NguyenDinhNhatNguyen/HRoT_SoC/README.md

# HRoT_SoC

SoC RISC-V hai lõi bất đối xứng với cách ly vật lý và khởi động bảo mật (Hardware Root of Trust & Secure Boot).
Master Core băm firmware của App Core bằng SHA-256 phần cứng (CPU hoặc Secure DMA), khối Boot_Verifier tự so digest với golden hash trong Boot ROM,
và App Core chỉ được nhả reset khi phần cứng báo VERIFIED. Ảnh sai thì Boot Guard khóa App tới khi cấp nguồn lại và xóa RAM App.

## Chạy nhanh (trong WSL, tại thư mục gốc repo)

| Lệnh | Việc |
| --- | --- |
| `make test` | Regression toàn bộ bằng QuestaSim + SystemC (TB đơn vị, lõi, UVM, HAL, ngoại vi APB, Boot_Verifier, SoC secure boot, firmware thật của hai lõi, ngắt, access fault, top ASIC `ASIC_Top`, VP) |
| `make cov` | Coverage trên QuestaSim (code coverage và covergroup của lõi, SHA-256, APB), báo cáo ở `build/cov/` |
| `make sim-unit` | 11 testbench đơn vị của lõi |
| `make sim-core TB=RISCV_Core_tb` | Mô phỏng lõi (mặc định `RISCV_Core_prog_tb`) |
| `make sim-uvm TEST=<test> SEED=<n>` | UVM AXI4-Lite (mặc định `axi4_lite_full_test`) |
| `make sim-soc` / `make sim-ip` / `make sim-bv` | Mô phỏng toàn SoC / ngoại vi APB (SYSCSR, UART, GPIO, TIMER, WDT, PLIC, Mailbox) / Boot_Verifier và cổng nhả App |
| `make vp` | Virtual Platform SystemC chạy HAL thật (image đúng và image bị sửa) |
| `make fw` | Build firmware Master và App (`fw/build/firmware_imem.hex`, `firmware_dmem.hex`, `app_firmware.hex`) |
| `make de2` | Quartus II 13.0sp1 cho DE2 (Cyclone II), kết quả trong `fpga/intel/de2/build` |
| `make xilinx PART=<part>` | Vivado 2025.2 cho Artix-7 thử, kết quả trong `fpga/xilinx/artix7/build` |
| `make kv260` | Vivado 2025.2 cho Kria KV260, ra `fpga/xilinx/kv260/build/kv260.bit` |
| `make asic-yosys` | Số sơ bộ ASIC của `SoC_Top` bằng Yosys + NanGate45 trong docker (xem `asic/README.md`) |
| `make asic-genus` | Tổng hợp `ASIC_Top` bằng Genus + GPDK45, chỉ chạy trên server trường (xem `asic/README.md`) |

Quy ước: chỉ làm việc trên nhánh `main`, chạy `make test` trước khi push. Mô phỏng chỉ dùng QuestaSim
(Makefile gọi Questa/Quartus/Vivado trên Windows qua WSL interop, đường dẫn đặt ở đầu Makefile).
Mỗi testbench in một dòng tổng kết bằng tiếng Anh (`... RESULT: PASS|FAIL`, `SUMMARY ...`, `TEST PASSED`) để `sim/regress.sh` đọc.

## Cấu trúc

```text
HRoT_SoC/
├── rtl/            RTL dùng chung cho mô phỏng và FPGA (xem rtl/README.md)
│   ├── core/       lõi RV32I 5 tầng, có Zicsr và trap máy
│   ├── bus/        AXI4-Lite master/slave, cầu AXI→APB, bộ giải mã APB, Secure DMA và tường lửa
│   ├── periph/     SYSCSR, Boot_Verifier, UART, GPIO, TIMER, WDT, PLIC-lite, Mailbox, FIFO
│   ├── mem/        Boot ROM, RAM, ROM App hai cổng
│   ├── crypto/     lõi SHA-256 và vỏ AXI
│   └── top/        RISCV_Core.v, SoC_Top.v
├── dv/             kiểm chứng (xem dv/README.md)
│   ├── tb/         testbench lõi, tb/soc/ chứa testbench ngoại vi APB và toàn SoC
│   ├── agents/ env/ tests/   môi trường UVM AXI4-Lite, SHA-256 và APB
│   └── sw/         mkhex.py: firmware thử viết tay cho SoC_Top_tb và FPGA
├── fw/             firmware: HAL, driver, crt0, linker script, Secure Boot (Master) và app demo (App)
├── vp/             Virtual Platform SystemC/TLM-2.0 (xem vp/README.md)
├── sim/            script Questa, regress.sh, run_vp.sh
├── fpga/           top bọc chân, constraints, script build và báo cáo FPGA (xem fpga/README.md)
├── asic/           top cấp chip ASIC_Top, SDC, luồng thử Yosys, luồng Genus (xem asic/README.md)
├── pd/             luồng ASIC (constraints, scripts, reports)
└── docs/           tài liệu (xem docs/README.md)
```

Tài liệu nên đọc trước: [docs/guides/Dev_Guide.md](docs/guides/Dev_Guide.md) (phân công, quy ước, cách chạy),
[docs/spec/SoC_Memory_Map.md](docs/spec/SoC_Memory_Map.md) (bản đồ địa chỉ và thanh ghi),
[docs/spec/Security_Model.md](docs/spec/Security_Model.md) (mô hình bảo mật, yêu cầu và truy vết) và
[docs/diagrams/](docs/diagrams/README.md) (bộ sơ đồ kiến trúc và lưu đồ, mở bằng draw.io).
