NguyenDinhNhatNguyen/HRoT_SoC/docs/project/Project_Status.md

# Trạng thái dự án — HRoT SoC

> Cập nhật: 13/11/2026. Ngày 12/11: Phát chạy Genus lần đầu cho `ASIC_Top` trên server trường (P-20), đạt timing từ 20 tới 8 ns, kết quả ở `asic/README.md`. Ngày 09/11: Phát thêm `asic/ASIC_Top.v` (bộ đồng bộ reset) và `asic/ASIC_Top.sdc` cho N-30. Ngày 07/11: lõi có `instr_stall` (I-09), `VERIFY_GATE` mặc định 1 trong `SoC_Top`, Nguyên chốt kit KV260 và bộ sơ đồ lên 21 trang (N-31). Ngày 05/11: Phát xong P-19 coverage, `make cov`. Ngày 04/11: Phát xong P-13 tới P-18 và P-24, Nguyên xong N-37 Boot_Verifier, N-38 mô hình bảo mật, N-39 đo lại FPGA. Phần RTL của Nguyên tới RTL freeze xong từ 26/10, N-37 bổ sung sau rà soát 04/11. Tiến độ chi tiết theo từng việc nằm ở [Google Sheet "HRoT_SoC — Tiến độ Đồ án 2"](https://docs.google.com/spreadsheets/d/13jJj9UP1Cxr8ZNFqzQnNTaiulD2_HaKOWAONfCnZnU4/edit) (tab Tổng hợp, Tiến độ, Mốc & Giao diện). Sheet là nguồn chính thức, khi lệch thì theo sheet. File này tóm tắt trạng thái kỹ thuật, sửa mỗi khi xong một mốc hoặc chốt một quyết định.

## 1. Tổng quan

- Toàn dự án 56/65 việc (86%, theo Sheet ngày 05/11, Sheet vẫn là nguồn chính thức): Nguyên 34/39, Phát 22/24, việc chung 0/2. Việc Nguyên còn lại: N-26 (RTL freeze), N-28, N-29, N-30, N-31. Việc Phát còn lại: P-20, P-21. Ngày 04/11: 55/65, Phát 21/24. Trước đó, 26/10: 45/61, Nguyên 31/36, Phát 14/23. Ngày 26/10 Phát làm xong P-09, P-10, P-11, P-23. Ngày 26/10 Nguyên làm xong N-19…N-25, N-27, N-32 và N-35. Ngày 25/10 thêm 6 việc phát sinh (N-32…N-36, P-22), danh sách rủi ro và hướng xử lý ở `Project_Plan.md` mục 8. RTL FREEZE: **22/11/2026** (mốc M2).
- SoC biên dịch và chạy được: Master boot từ Boot ROM riêng, băm cả 4 KB ROM App bằng CPU và bằng Secure DMA (qua tường lửa), so với golden hash đọc từ Boot ROM, rồi nhả App qua SYSCSR, hoặc khóa App bằng Boot Guard và xóa RAM App khi hash sai. Bus APB Secure có SYSCSR, UART0, GPIO0, TIMER0, WDT, PLIC-lite, Mailbox và Secure DMA. Thế giới App có bus APB riêng với UART1, GPIO1, TIMER1 và Mailbox. `SoC_Top_tb` chạy cả ảnh đúng lẫn ảnh bị sửa trên RTL (firmware thử `dv/sw/mkhex.py`). Dây ngắt của hai lõi đã nối vào cổng `irq_timer`/`irq_ext` của lõi (P-14, 27/10, I-01), `SoC_Irq_tb` kiểm ngắt timer, PLIC và Mailbox trên cả hai lõi.
- FPGA (26/10, đo với lõi đã đổi reset đồng bộ ở `IF_ID_Reg` và `ID_EX_Reg`, xem mục 4): DE2 9.358 LE (28%), 4.390 thanh ghi, 135 Kbit M4K, Fmax 53,02 MHz. Artix-7 xc7a35t 5.530 LUT (27%), 4.092 FF, WNS +3,519 ns @ 50 MHz. Đường găng DE2 nằm trong lõi (`Rd_WB` → forwarding ở ID → `RD2_EX`, slack +1,14 ns), không có đường nào của uncore trong top. Báo cáo ở `fpga/reports/`. Lần đo mới nhất (04/11, có P-09, P-14, P-24, Boot_Verifier và cổng nhả App bật): DE2 10.982 LE (33%), 4.925 thanh ghi, 135.168 bit, Fmax 54,07 MHz (slack +1,505 ns). Artix-7 6.136 LUT (29,5%), 4.401 FF, WNS +3,273 ns, WHS +0,014 ns (sát). Lần 27/10 (DE2): 10.509 LE, 54,21 MHz. Số của mọi lần đo: [FPGA_Results.md](FPGA_Results.md).
- Firmware Secure Boot thật có từ 27/10 (P-13): `fw/secure_boot/secure_boot.c` băm cả 4 KB ROM App bằng Secure DMA (`SWAP` + `PAD`, từ 29/10, P-15, trước đó bằng HAL), so golden ở `0xFE0` trong Boot ROM, nhả App hoặc khóa bằng Boot Guard, log qua UART0, kết quả ra LED GPIO0. Chạy trên VP (`vp_sim --fw`) và trên RTL (`SoC_Fw_tb`). Từ 29/10 có firmware App demo (`fw/app`, P-16): LED GPIO1 chạy theo TIMER1, gửi tin qua Mailbox, Master in tin đó ra UART0. `SoC_App_tb` chạy cả hai firmware thật với golden lấy từ build. `SoC_Top_tb` vẫn dùng firmware thử viết tay (`dv/sw/mkhex.py`).

Kết quả kiểm tra gần nhất trên Questa 10.2c (`make test`, 11/11 trên máy Phát): 22/22 PASS, 11 assertion của lõi 0 lỗi. Mục thứ 22 là `ASIC_Top_tb` (bộ đồng bộ reset của top ASIC), đưa vào `make test` cùng ngày. Lần 07/11 (`ce29a2e`) 21/21 và 05/11 cũng PASS toàn bộ. Hai mục UVM SHA-256 FAIL ngày 04/11 (341 lỗi) là do scoreboard tính sai chỉ số H0..H3 (`off[4:2] + 3'd4` được Questa tính ở 32 bit nên ra 8), DPI không lỗi, Phát sửa 05/11 (P-17). Cùng ngày chạy thêm trên Questa 19 lần test UVM mà sheet chỉ ghi kết quả Verilator, tất cả PASS. Bảng dưới là lần chạy 26/10, giữ để so:

| Nhóm | Kết quả |
| --- | --- |
| Lõi: 11 TB đơn vị, chương trình ISA, `RISCV_Core_tb`, hazard | PASS (11 TB đơn vị và UVM chạy được trên Questa sau khi Phát sửa P-22) |
| UVM AXI4-Lite (full, reset giữa giao dịch) và UVM SHA-256 (full, có reset) | PASS (26/10). 04/11: AXI4-Lite và APB PASS, SHA-256 hai mục FAIL. 05/11: tất cả PASS sau khi sửa scoreboard SHA |
| Boot_Verifier và cổng nhả App (`Boot_Verifier_tb`, 04/11) | PASS, 30/30: hash sai bit ở từ 0 và từ 7, SHA chưa xong hoặc bận, rollback, `MIN_VER` chỉ tăng, slot HMAC, `KEY_LOCK` qua SW reset, POR mở lại |
| SoC với `VERIFY_GATE = 1` (04/11) | PASS: ghi `APP_RUN` trước `CHECK` bị từ chối, ảnh đúng `STATUS` 0x9, ảnh sửa 0xA, đọc ngoài 4 KB ra `DECERR`, 7 lỗi bus cố ý được trap handler đếm đủ |
| HAL SHA-256 trên host | PASS |
| Ngoại vi APB (SYSCSR gồm BUS_ERR và Boot Guard, GPIO, UART, TIMER, WDT, PLIC-lite, Mailbox) | PASS, 79/79 check |
| SoC secure boot, ảnh đúng | PASS: hash của CPU và của DMA (SWAP bật và tắt) khớp golden trong Boot ROM, PLIC và tường lửa đúng, App chạy |
| SoC secure boot, ảnh bị sửa 1 bit (`+TAMPER`) | PASS: Boot Guard khóa App kể cả khi firmware cố nhả lại, RAM App về 0, không có yêu cầu DMA nào ra ngoài cửa sổ cho phép |
| VP (ảnh đúng và ảnh bị sửa) | PASS (UART log, WDT, Boot Guard, DMA, tường lửa) |
| `sha256_alias_test` (chạy riêng) | PASS |

Trên Verilator (Phát chạy, 23–25/10): UVM AXI4-Lite 15/15 PASS. UVM SHA-256 trên DUT thật: KAT, CTL (khoảng 960 check), RAND 40 message × 3 seed (khoảng 4.300–4.900 check), FULL, reset giữa message × 3, tất cả PASS, 0 lỗi.

Tới 29/10 (Phát chạy bằng iverilog, Verilator và trên host, **chưa chạy trên Questa**): 11 TB đơn vị, `RISCV_Core_tb`, hazard, chương trình `core_isa_test` và `core_trap_test` (có và không `bus_stall`), `SoC_Top_tb`, `SoC_Fw_tb` và `SoC_App_tb` (ảnh đúng và `+TAMPER`), `SoC_Irq_tb`, UVM 9 test (26/10), host `drv_host_test` 59/0, `sb_host_test` 69/0, `rom_image_test.py` 26/0, HAL 9.692/0, `make fw`, VP 4/4 đều PASS. `APB_Periph_tb` đạt 78/79 trên iverilog do race của PLIC ở thời điểm 0 (phần của Nguyên), trên Questa 26/10 thì 79/79.

## 2. Phần của Phát

| ID | Việc | Hạn | Trạng thái |
| --- | --- | --- | --- |
| P-01…P-06 | Lõi 5 tầng, hazard + test ISA, khung UVM, HAL + test plan, toolchain, load/store byte/half | ≤ 25/10 | ✅ Xong |
| P-07 | Sơ đồ khối datapath 5 tầng trong `docs/` | 13/09 | ✅ Vẽ từ Tuần 1, đưa vào repo 25/10: `docs/spec/Core_Datapath.md` + hình, có bảng đối chiếu RTL và 5 điểm nên sửa khi vẽ lại cho báo cáo (commit `fb0b577`) |
| P-08 | UVM sequence ngẫu nhiên cho SHA-256 (corner case) | 25/10 | ✅ Xong 25/10 (commit `bb59f25`). `sha256_alias_test` PASS sau khi Nguyên sửa RTL 25/10 |
| **P-09** | Zicsr + trap máy + cổng `irq_timer`/`irq_ext` | 01/11 | ✅ Xong 26/10 (commit `9f9e66a`): `Sys_Decoder`, `CSR_Unit`, `Pipe_Reg`, cổng `irq_timer`/`irq_ext` theo I-01 (xem `Dev_Guide.md` mục 2). Test `core_trap_test` (CSR, ECALL, EBREAK, lệnh không hợp lệ, MRET, ngắt timer/external) PASS có và không `bus_stall`, bắt được 9/9 lỗi cài thử. Dây ngắt nối trong `SoC_Top.v` từ 27/10 (P-14, R16). Access fault qua `data_err` (mcause 5/7) làm ở P-24 (04/11) |
| P-10 | Dọn `dv/tb` sang `dv/env`, `dv/agents` | 01/11 | ✅ Xong 26/10 (commit `9f9e66a`): `tb_top.sv`, `tb_sha256_top.sv` sang `dv/env/`, `axi4_lite_slave_model.sv` sang `dv/agents/`, sửa `sim/run_uvm.do`. `dv/tb/` chỉ còn TB trực tiếp |
| P-11 | Driver UART/GPIO theo `SoC_Memory_Map.md` | 01/11 | ✅ Xong 26/10 (commit `9f9e66a`): `fw/hal/uart.h`, `gpio.h` (một driver cho cả UART0/GPIO0 và UART1/GPIO1), thư viện `hal_drivers` trong CMake, test host `drv_host_test` 49/0 chạy trong `make -C fw/hal/test test` |
| P-12 | Cập nhật tài liệu này + `Dev_Guide.md`, thêm test của Phát vào `make test` | 01/11 | ✅ Xong (làm 24/10, vào `main` cùng commit P-08 `bb59f25`), sheet đã cập nhật 25/10 |
| P-23 | Sửa lỗi Quartus 10200 ở `IF_ID_Reg.v` và `ID_EX_Reg.v`: đổi `always @(posedge clk or posedge rst)` thành `always @(posedge clk)` (mục 4, R15) | 01/11 | ✅ Xong 26/10 (commit `9f9e66a`). Chạy lại iverilog: TB đơn vị, lõi, SoC (ảnh đúng và `+TAMPER`) PASS. `make de2` trên máy Phát 26/10 (bản có cả P-09): biên dịch sạch, không còn lỗi 10200, DE2 10.270 LE (31%), 4.840 thanh ghi, Fmax 53,73 MHz, đường găng vẫn trong lõi (`Rd_WB` → forwarding ở ID → `RD1_EX`, slack +1,39 ns) |
| P-22 | Sửa 2 lỗi script trên Questa 10.2c (mục 4) | 01/11 | ✅ Xong: Phát sửa 25/10 (commit `fb0b577`), Nguyên chạy `make test` trên Questa 26/10, 11 TB đơn vị và 4 test UVM PASS |
| P-13 | Firmware secure boot thật (HAL + UART + golden + LOCK), chạy VP rồi RTL | 08/11 | ✅ Xong 27/10 (`c739654`): `fw/secure_boot/secure_boot.c` theo đúng ghi chú (BUS_ERR → log, giữ App, xóa bit0. Golden băm đủ 4 KB ROM App). `linker.ld` đặt `.rodata` vào Boot ROM, golden ở `0xFE0` (I-03). Firmware build `-Os` (3,5/4 KB ROM). Test: `sb_host_test` 30/0 (8 nhánh, gồm lỗi bus, SHA hỏng, LOCK không xong), VP `--fw` ảnh đúng và bị sửa PASS, `SoC_Fw_tb` ảnh đúng và `+TAMPER` PASS. 04/11 theo ghi chú của Nguyên: mọi lỗi (self-test, bus, DMA) đều khóa App bằng Boot Guard như khi sai hash, WDT 1 s bật từ đầu và được đá mãi sau boot, kiểm `BUS_ERR` lại sau khi đọc golden. `sb_host_test` 80/0 |
| P-14 | Test assembly ngắt timer/external | 08/11 | ✅ Xong 27/10 (`c739654`): nối 4 dây ngắt trong `SoC_Top.v` (Phát làm, đã báo Nguyên). `SoC_Irq_tb` + `soc_irq_master.S`, `soc_irq_app.S`: TIMER0, GPIO0 qua PLIC, MEI trước MTI, Mailbox hai chiều, TIMER1. Master 5 ngắt, App 2 ngắt, PASS. Tháo từng dây hoặc đảo ưu tiên đều làm test FAIL |
| P-15 | FW dùng Secure DMA | 15/11 | ✅ Xong 29/10: driver `fw/hal/dma.c` (`dma_sha256`: kiểm DMA và SHA rảnh, chạy với `PAD`, polling có giới hạn và nghỉ giữa các lần đọc, xóa `DONE`, báo lỗi tường lửa, lỗi bus, timeout). Secure Boot băm ROM App bằng DMA `SWAP = 1`, khớp golden ở `0xFE0`. CPU không còn đọc ROM App, firmware còn 3.320/4.064 byte. Test: `sb_host_test` 63/0 (thêm tường lửa, DMA không xong, DMA hoặc SHA đang bận, bắt 10/10 lỗi cài thử), VP `--fw` PASS, `SoC_Fw_tb` ảnh đúng và `+TAMPER` PASS (DMA chạy 1 lần, 17.026 chu kỳ, CPU tự băm mất 34.143) |
| P-16 | FW App + `app_firmware.hex` + sinh golden hash | 15/11 | ✅ Xong 29/10: `fw/app` (UART1 "App running", LED GPIO1 chạy theo TIMER1, gửi `APP1` rồi số bước qua Mailbox), Master in tin Mailbox ra UART0 sau khi nhả App. `app.ld` chặn `.rodata`/`.data` vì lõi App không đọc được ROM của nó. `make fw` tạo `app_firmware.hex`/`.bin` đủ 4 KB và ghi golden vào `firmware_imem.hex` (`fw/tools/rom_image.py`, I-04). Driver Mailbox mới, `uart_put_hex32` bỏ bảng hằng. Test: `drv_host_test` 59/0, `sb_host_test` 69/0, `rom_image_test.py` 26/0, `SoC_App_tb` ảnh đúng và `+TAMPER` PASS, bắt 4/4 lỗi cài thử |
| P-17 | UVM agent APB + scoreboard SHA (DPI) | 15/11 | ✅ Xong 30/10 (`ae92653`): agent APB (`dv/agents/apb_*`, SVA giao thức) và top `tb_apb_top.sv` lái `APB_Decoder`, GPIO, TIMER, Mailbox hai phía thật cùng một slave RAM có wait state. `apb_scoreboard` dự đoán mọi lần đọc và `PSLVERR` của cả hai bus. Scoreboard SHA thụ động với golden `sha256_ref.c` qua DPI và reg model khớp chu kỳ, bật trong mọi test `sha256_*`. Verilator: `apb_full_test` 5 seed và `apb_reg_test` 2.000 transfer có reset PASS, 0 lỗi. `sha256_full_test` 1.701 lần đọc, 0 lỗi. Lỗi cài vào RTL mà sequence không thấy: scoreboard bắt 3/3 (DONE trễ 1 chu kỳ, HASH đọc 0 khi BUSY, TIMER ghi lệch). Lỗi cài vào Mailbox chưa build được trên Verilator. Questa 10.2c báo 3 lỗi làm cả 5 test UVM FAIL (Nguyên, 04/11): tên `check` trùng với `uvm_component`, gcc của Questa mặc định C89, kiểu virtual interface không có instance. Đã sửa 04/11 (`check_item`, `-ccflags -std=gnu99`, instance không dùng trong các top UVM). 05/11 sửa chỉ số H0..H3 của scoreboard SHA (Questa tính `off[4:2] + 3'd4` ở 32 bit). Questa 10.2c 05/11: 12 test UVM, 24 lần chạy nhiều seed, PASS 0 lỗi |
| P-18 | Test firmware toàn SoC + regression UVM | 22/11 | ✅ Xong 04/11 (commit `a05aef7`): firmware dùng Boot_Verifier theo I-08 (driver `fw/hal/boot_verifier.c`, đọc APP_VER ở `0x6000_0FFC`, CHECK MODE 0, VERIFIED và phần mềm cũng khớp thì KEY_LOCK rồi nhả App, đọc lại APP_RUN, lỗi thì khóa App với mã LED `BF`). `SoC_Fw_tb` và `SoC_App_tb` bật `VERIFY_GATE = 1`. VP có mô hình Boot_Verifier. `regress.sh`: SKIP tính là FAIL (`ALLOW_SKIP=1` để bỏ qua), TB 0 check không còn PASS, `SEED=<n>` đổi seed. Firmware build với `-flto` (3.384/4.032 byte). Test: `sb_host_test` 99/0, bắt 4/4 lỗi cài thử, VP 4/4, các TB SoC PASS. Questa 10.2c 05/11: `SoC_Fw_tb`, `SoC_App_tb` (ảnh đúng, `+TAMPER`), `SoC_Irq_tb` PASS |
| P-24 | Access fault qua `data_err` (cổng trong lõi + trap handler firmware) | 22/11 | ✅ Xong 04/11 (commit `dca8cbf`): `CSR_Unit` trap `mcause` 5/7 với `mtval` = địa chỉ khi `data_err` lúc truy cập kết thúc. `crt0.S` đặt `mtvec`, `trap_handler` của Master khóa App và KEY, LED `0xAF`. Nguyên nối `master_data_err` trong `SoC_Top` và thêm trap handler cho `mkhex.py` cùng ngày (`e14eb4f`), lõi App vẫn nối 0. Test: `core_trap_test` thêm load/store lỗi (có và không `bus_stall`), bắt 4/4 lỗi cài vào RTL, `sb_host_test` 102/0, `SoC_Fw_tb +FAULT` (ép `data_err` khi đọc APP_VER). Questa 10.2c 05/11: `core_trap_test` và `SoC_Fw_tb +FAULT` PASS |
| P-19 | Covergroup + thu coverage | 29/11 | ✅ Xong 05/11 (commit `4b3c481`): `make cov` (`sim/cov.sh`) chạy trên Questa 12 lần (lõi, SHA-256, APB) với code coverage và covergroup (`sha256_coverage.svh`, `apb_coverage.svh`, covergroup trong `RISCV_Core_prog_tb`, chỉ biên dịch khi có `+define+HROT_COV`). Functional coverage 16 covergroup đều 100%. Code coverage: `SHA256_Wrapper`, `SHA256_Core`, GPIO, TIMER, Mailbox 100%, lõi 99% statement, 98,6% branch. Coverage tìm ra 4 lỗ hổng test (ORI, FENCE/FENCE.I/WFI, mã lệnh dành riêng, CSR ID và ghi `mcause`/`mtval`), đã thêm vào `core_isa_test` và `core_trap_test`. Thêm `sha256_reg_test` (F-REG-01/02), `+RESET_EVERY_NS`, `pick_len` tôn trọng `+MAX_LEN`. 07/11: 11 assertion SVA bind vào lõi (`dv/tb/RISCV_Core_sva.sv`), bắt 3/3 lỗi cài vào `CSR_Unit`, trong đó 1 lỗi test chương trình không bắt được. Chi tiết: test plan SHA-256 mục 6 |
| P-20, P-21 | Báo cáo coverage + Genus · Innovus + so sánh PPA | 06/12 → 13/12 | P-20 đang làm: Genus chạy 12/11 (20 ns: slack +6,98 ns, 73.256 µm² logic, bộ nhớ là black box). P-21 chưa làm |

## 3. Giao diện Nguyên ↔ Phát

| ID | Nội dung | Hạn | Trạng thái |
| --- | --- | --- | --- |
| I-01 | Cổng ngắt của lõi: `irq_timer`, `irq_ext`: đầu vào mức cao, đồng bộ `clk`, giữ mức tới khi nguồn tự xóa (TIMER0: ghi `mtimecmp`, PLIC: claim/complete), lõi không bắt cạnh → `mip.MTIP` (bit 7) / `mip.MEIP` (bit 11), ưu tiên MEI > MTI. `data_err` mức cao cùng chu kỳ với `resp_valid` (nối `err_valid` của `AXI4_Lite_Master`) → access fault `mcause` 5 (load) / 7 (store), `mtval` = địa chỉ | 01/11 | ✅ **Đã chốt 25/10** (Phát). Lõi có cổng từ P-09 (26/10, commit `9f9e66a`), nối trong `SoC_Top` từ 27/10 (P-14). `data_err` có trong lõi từ 04/11 (P-24), nối vào lõi Master trong `SoC_Top` cùng ngày (`e14eb4f`), lõi App nối 0 |
| I-02 | Header địa chỉ firmware theo `SoC_Memory_Map.md`, đổi map phải báo trước | 01/11 | Nguyên |
| I-03 | Địa chỉ golden hash trong Boot ROM (cổng đọc dữ liệu) + đổi `linker.ld` đặt `.rodata` vào đó | 08/11 | ✅ Xong 27/10: `.rodata` trong Boot ROM, golden ở `0xFE0` (`SB_GOLDEN_ADDR`). Chốt 04/11: golden là 8 word big-endian H0..H7 (khớp Boot_Verifier), tag HMAC ở `0xFC0`, code dùng tới `0xFBF` |
| I-04 | Target CMake `app_firmware.hex` + bước sinh golden hash (băm **cả 4 KB** ROM App) | 15/11 | Phát. Xong 29/10 (P-16) |
| I-05 | SHA-256: 66 chu kỳ START→DONE, offset trống OKAY/0, ngoài slave DECERR | — | ✅ Đã chốt, RTL đã khớp từ 25/10 |
| I-06 | UART `BAUD_DIV` mặc định 26 = 115200 baud @ 50 MHz | — | ✅ Đã chốt |
| I-07 | Chỉ commit trên `main`, chạy trong WSL, mô phỏng Questa, `make test` PASS trước khi push | — | ✅ Đã chốt |
| I-08 | Firmware dùng Boot_Verifier (`0x4000_8000`), MODE 0: DMA băm xong thì không đụng SHA tới khi `CHECK` xong, ghi `APP_VER`, `CHECK`, chờ `CHECKED` có giới hạn. `VERIFIED` và phần mềm cũng khớp thì `KEY_LOCK` rồi `APP_CTRL = 1`, `FAIL` thì Boot Guard LOCK | 15/11 | ✅ Xong 04/11 (P-18), `VERIFY_GATE = 1` ở FPGA và TB firmware, mặc định 1 trong `SoC_Top` từ 07/11 |
| I-09 | Bộ nhớ cho ASIC (R8): SRAM macro đọc cạnh lên trễ 1 chu kỳ. MEM dùng lại `bus_stall`, IF có cổng `instr_stall` (đầu vào mức cao, đồng bộ `clk`). FPGA nối `instr_stall = 0` | 22/11 | ✅ Chốt 07/11, phía lõi xong 07/11 (`1cf00e6`). Còn Nguyên nối dây và làm bộ nhớ cạnh lên cho bản ASIC |

Các lỗi SoC/uncore liệt kê ở bản trước (SoC không compile, Master fetch ROM App, ROM đọc đồng bộ, `bus_stall` trễ, thiếu WSTRB, SHA chưa băm, Reset Controller treo, VP thiếu `sc_main`…) **đều đã được Nguyên sửa** trong các commit `459f4fe`…`bb8288a`.

## 4. Điểm cần lưu ý

- **Cổng nhả App bằng phần cứng (N-37, 04/11):** `Boot_Verifier` (APB slot 8, `0x4000_8000`) tự đọc golden hash từ Boot ROM và so 8 từ với digest SHA-256, cộng chống rollback (`MIN_VER`) và khóa HMAC (`KEY_LOCK`). Với `SoC_Top` `VERIFY_GATE = 1`, `SYSCSR` bỏ qua `APP_RUN` tới khi `VERIFIED`. `DE2_Top`, `Xilinx_Top` và các TB firmware bật cổng, `SoC_Irq_tb` để 0. Chi tiết: `docs/spec/SoC_Memory_Map.md` mục Boot_Verifier và `docs/spec/Security_Model.md`. Kèm theo: Boot_Verifier mượn cổng B của Boot ROM (cổng đọc thứ ba làm Quartus bỏ cả lõi Master, mô phỏng không thấy), ba bộ nhớ 4 KB giải mã đúng 4 KB (ngoài vùng ra `DECERR`), `master_data_err` nối vào lõi Master (P-24).
- **Việc của Nguyên:** N-33 (VP băm cả 4 KB ROM App), N-34 (`fw/hal/soc_map.h`), N-36 (`SYSCSR.BUS_ERR`) xong 25/10. Ngày 26/10 xong N-19 (PLIC-lite), N-20 (Boot Guard + Zeroization), N-21 (cổng đọc dữ liệu Boot ROM ở `0x0000_0000`), N-22 (Secure DMA + một master AXI dùng chung cho CPU và DMA), N-23 (tường lửa DMA), N-24 (bus APB thế giới App với UART1, GPIO1, TIMER1), N-25 (Mailbox), N-27 và N-32 (VP có Boot ROM, UART0, TIMER0, WDT, Boot Guard, DMA), N-35 (`SoC_Top_tb` băm image App, thêm ảnh bị sửa). N-26 (đóng băng RTL 22/11): phần của Phát (P-09, P-23) xong 26/10, dây ngắt nối trong `SoC_Top` 27/10 (P-14). N-18 xong: 52/52 chân trong `fpga/intel/de2/de2_pins.tcl` khớp bảng chân của DE2 User Manual v1.3.
- **Lỗi Quartus 13 trong lõi (Nguyên phát hiện 26/10, Phát sửa cùng ngày ở commit `9f9e66a`, P-23):** commit `fb0b577` gộp `if (rst || flush)` vào khối `always @(posedge clk or posedge rst)` của `IF_ID_Reg.v` và `ID_EX_Reg.v`. Quartus báo lỗi 10200 ("cannot match operand(s) in the condition to the corresponding edges") nên `make de2` không chạy được. Đề xuất đổi hai khối đó sang `always @(posedge clk)`, reset đồng bộ, hợp với `sys_rst` đồng bộ của SoC. Nguyên đã thử: `make test` PASS, Quartus và Vivado build được, số đo ở trên là của bản này.
- **Thứ tự byte của golden hash (I-04):** CPU chép từng từ vào SHA-256 nên thông điệp là các byte big-endian của từng từ. Secure DMA có bit `SWAP`: bật thì đảo byte từng từ, digest bằng `sha256sum` của file `.bin` (little-endian), cũng là kết quả của HAL và VP. Golden của firmware thật là `sha256sum` của `.bin`, băm bằng DMA với `SWAP = 1` (firmware làm vậy từ 29/10, P-15). `dv/sw/mkhex.py` giữ cả hai golden trong Boot ROM để test. Từ 04/11 golden lưu dưới dạng 8 word big-endian H0..H7 (word i = 4 byte 4i..4i+3 của digest, byte đầu ở bit cao), là cách `Boot_Verifier` (N-37) so với kết quả SHA. Đã thử trên RTL: Boot_Verifier báo VERIFIED với ảnh Boot ROM do `make fw` tạo, FAIL khi digest sai 1 bit.
- **DMA và SHA-256:** khi DMA `BUSY` thì nó giữ SHA-256, firmware chờ `DONE` rồi mới đọc kết quả hoặc dùng SHA. Từ 29/10 `dma_sha256` làm đúng vậy, khi DMA không xong thì không đụng SHA nữa và giữ App trong reset (P-15).
- **Cấu trúc repo đổi từ 25/10:** `doc/` thành `docs/` (chia `spec`, `verification`, `guides`, `project`), `rtl/uncore/` tách thành `rtl/bus`, `rtl/periph`, `rtl/mem`, `rtl/crypto`, `syn/` thành `fpga/` (thêm `fpga/reports`), `mkhex.py` sang `dv/sw/`. Phải `git pull` trước khi sửa tiếp.
- **Lỗi RTL SHA-256 (P-08 phát hiện), đã sửa 25/10:** `SHA256_Wrapper` chỉ giải mã `addr[7:0]` trong khi `SoC_Top` cấp cửa sổ 64 KB, nên offset ≥ `0x100` bị alias vào thanh ghi thật. Wrapper giờ giải mã `addr[15:8] == 0`, `sha256_alias_test` PASS trên Questa (chạy với `+TEST_TIMEOUT_US=100000000`, xem mục dưới).
- **Ba lỗi khi chạy trên Questa 10.2c (Nguyên phát hiện 25/10, trên Verilator không gặp). Lỗi 1 và 2 Phát sửa 25/10, Nguyên chạy lại trên Questa 26/10 PASS (P-22):**
  1. Timeout UVM tính bằng `time'(real'(tmo_us) * 1us)` trong `dv/tests/base_test.svh` ra 1,6 µs thay vì 1600 µs, do lệch timescale giữa package và `uvm_pkg`. 4 test UVM trong `make test` chết vì `PH_TIMEOUT`.
  2. `vsim -onfinish stop` trong `sim/run_unit.do` làm macro dừng sau `ALU_tb` ở chế độ `-c`, chỉ 1/11 TB chạy. Chạy `make test` trong terminal thì Questa đứng chờ ở dấu nhắc `VSIM(paused)>` và cả regression bị treo. Tạm thời chạy `make test < /dev/null`.
     Cách sửa (25/10): `base_test.svh` bỏ `uvm_top.set_timeout()` (đối số bị đọc theo đơn vị thời gian của `uvm_pkg`, trên Questa là 1 ps theo `-t 1ps`) và dùng watchdog `#(timeout_us * 1us)` ngay trong package của test nên luôn đúng đơn vị. `regress.sh` chạy mỗi TB đơn vị bằng một tiến trình `vsim` riêng (`set UNIT <tb>`, cùng kiểu với `run_rtl.do`) và mọi lệnh `vsim` đọc stdin từ `/dev/null` nên không còn treo ở `VSIM(paused)>`.
  3. (Đã sửa, phía Nguyên) `sim/run_vp.sh` trước đây chỉ tìm thư viện ở `$SYSTEMC_HOME/lib-linux64`, nên link lỗi khi `SYSTEMC_HOME` trỏ tới bản 2.3.4 (thư viện nằm trong `lib/`). Script giờ thử cả hai.
- **Comment và chuỗi in ra của testbench viết bằng tiếng Anh** từ 25/10. File của Nguyên đã đổi, file của Phát đổi hết ngày 25/10 (commit `fb0b577`).
- **VP băm cả 4 KB ROM App** theo I-04 từ 25/10 (N-33, commit `a946e2a`).
- **Bộ nhớ đọc ở cạnh xuống** chạy tốt trên FPGA nhưng không hợp với SRAM macro khi làm ASIC (P-20/P-21). Phía lõi đã sẵn sàng từ 07/11 (R8): ở MEM dùng lại `bus_stall`, ở IF có cổng `instr_stall` (I-09, đã chốt 07/11, `SoC_Top` đang nối 0). Còn lại là bộ nhớ đọc cạnh lên cho bản ASIC (Nguyên), hoặc dùng flip-flop cho bộ nhớ nhỏ.
- **Golden hash đặt được trong Boot ROM từ 26/10 (N-21):** lệnh `lw` đọc được ROM ở `0x0000_0000` qua cổng B (chỉ đọc, ghi trả `SLVERR`). Từ 27/10 `linker.ld` đặt `.rodata` trong ROM và chừa `0xFE0`–`0xFFF` cho golden (P-13, I-03), từ 04/11 chừa thêm `0xFC0`–`0xFDF` cho tag HMAC. Từ 29/10 `make fw` tự ghi golden của `app_firmware.hex` vào `firmware_imem.hex` (I-04, P-16). `SoC_Fw_tb` và VP vẫn tự ghi golden của ảnh App thử.
- **Xuống dòng:** `.gitattributes` ép LF cho `*.sh`, `Makefile`, `*.tcl`. Nên thêm `* text=auto eol=lf` để file `.v/.sv/.c/.md` không bị đổi qua lại LF↔CRLF giữa hai máy.
- **WSL của Phát** đã cài `make`, `gcc`, `cmake`, toolchain RISC-V và SystemC 2.3.4 (25/10), chạy được `make fw`, `make vp` và test HAL. Từ 05/11 có QuestaSim 10.2c ở `D:\questasim64_10.2c` (cùng bản với Nguyên), chạy với `QUESTA=/mnt/d/questasim64_10.2c/win64/vsim.exe`. Từ 07/11 Windows của Phát có Python 3.12 từ python.org, nên 6 test firmware SoC trong `make test` (`run_fw.do` gọi `python`) chạy được và `make test` đạt 21/21.

## 5. Lỗ hổng so với lộ trình Tuần 16

- Kiểm chứng secure boot mức SoC với firmware thật (P-13, P-18): `SoC_Top_tb` kiểm cả ảnh đúng lẫn ảnh bị sửa nhưng bằng firmware thử viết tay. Từ 27/10 firmware C thật chạy trên RTL (`SoC_Fw_tb`), kịch bản lõi SHA hỏng mới kiểm trên host (`sb_host_test`).
- Hạ tầng coverage (P-19): xong 05/11 (`make cov`). Monitor AXI ghi cạnh VALID lên đầu tiên và cạnh B/R để đo thứ tự AW–W và độ trễ.
- GLS (P-20): `RISCV_Core_prog_tb` dùng lại được (bọc phần dump thanh ghi bằng `ifndef GLS`), `RISCV_Core_tb` chỉ chạy RTL.
