NguyenDinhNhatNguyen/HRoT_SoC/dv/README.md

# dv/

| Thư mục | Nội dung | Script chạy |
| --- | --- | --- |
| `tb/` | TB đơn vị của lõi, `RISCV_Core_tb`, `RISCV_Core_prog_tb` (chạy `core_isa_test` và `core_trap_test`), `RISCV_Core_hazard_tb`, `SoC_Fw_tb` (firmware Secure Boot thật trên SoC, P-13, băm bằng Secure DMA từ P-15), `SoC_App_tb` (firmware thật của cả hai lõi, golden lấy từ build, P-16), `SoC_Irq_tb` (ngắt hai lõi, P-14). Chỉ còn TB trực tiếp, không có file UVM. `RISCV_Core_sva.sv`: assertion bind vào mọi `RISCV_Core` (P-19, chỉ Questa). `ASIC_Top_tb.sv`: top ASIC (`asic/ASIC_Top.v`), bộ đồng bộ reset rồi firmware thật của hai lõi, nằm trong `make test` từ 11/11 | `sim/run_unit.do`, `sim/run_rtl.do`, `sim/run_fw.do` |
| `tb/soc/` | `APB_Periph_tb.sv` (SYSCSR gồm BUS_ERR và Boot Guard, UART, GPIO, TIMER, WDT, PLIC-lite, Mailbox), `Boot_Verifier_tb.sv` (Boot_Verifier và cổng nhả App, 30 check), `SoC_Top_tb.sv` (toàn SoC, chạy ảnh đúng và `+TAMPER`) | `sim/run_ip.do`, `sim/run_soc.do` |
| `agents/` | Agent AXI4-Lite (interface + SVA, driver, monitor, sequencer) và `axi4_lite_slave_model.sv` (slave AXI4-Lite mô hình hành vi). Agent APB (`apb_if.sv` có SVA, `apb_agent.svh`, `apb_driver.svh`, `apb_monitor.svh`...) và `apb_slave_model.sv` (RAM có wait state), P-17 | `sim/run_uvm.do` |
| `env/` | Env, scoreboard, mô hình SHA-256 và ba top UVM: `tb_top.sv` (slave mô hình), `tb_sha256_top.sv` (SHA-256 thật), `tb_apb_top.sv` (GPIO, TIMER, Mailbox hai phía sau `APB_Decoder` thật). P-17: `sha256_scoreboard.svh` (reg model khớp chu kỳ + golden C `sha256_ref_dpi.c` qua DPI), `apb_scoreboard.svh` (dự đoán thanh ghi của cả hai bus APB). P-19: `sha256_coverage.svh`, `apb_coverage.svh` (covergroup, chỉ biên dịch với `+define+HROT_COV`, chạy bằng `make cov`) | `sim/run_uvm.do` |
| `tests/`, `hrot_dv_pkg.sv` | Sequence, test UVM AXI4-Lite, SHA-256 và APB, package gom các lớp UVM | `sim/run_uvm.do` |
| `tests/asm/` | Chương trình tự kiểm tra: `core_isa_test` (RV32I), `core_trap_test` (Zicsr, trap, ngắt, P-09) cho lõi, `soc_irq_master`, `soc_irq_app` (ngắt trên SoC, P-14) | `sim/run_rtl.do`, `sim/run_fw.do` |
| `sw/mkhex.py` | Trình hợp dịch RV32I nhỏ, sinh `boot.hex` (firmware thử + hai golden hash ở `0x600`), `app.hex` (ảnh App 4 KB), `labels.vh` cho `SoC_Top_tb` và bản FPGA | `make sim-soc`, `make hex` |

Mỗi testbench tự kiểm tra và in một dòng tổng kết mà `sim/regress.sh` dò theo: `SUMMARY <NAME>: PASS = x | FAIL = y`, `<tb> RESULT: PASS|FAIL` hoặc `*** TEST PASSED ***` (UVM).
