NguyenDinhNhatNguyen/HRoT_SoC/docs/spec/Core_Datapath.md

# Sơ đồ khối datapath lõi RISC-V 5 tầng

> Người giữ: Phát (P-07). Cập nhật: 07/11/2026 (đối chiếu với trang 04 của bộ sơ đồ N-31), 26/10/2026 (thêm phần CSR và trap của P-09). RTL: `rtl/core/`, ghép tầng ở `rtl/top/RISCV_Core.v`.

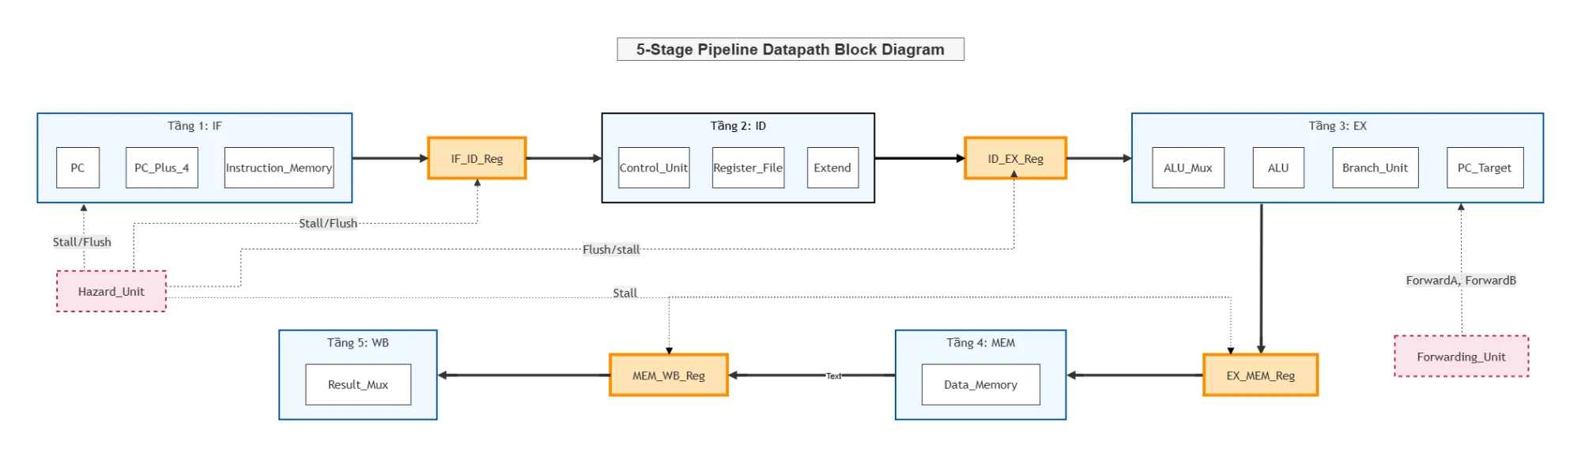
[picture p1: docs/spec/img/core_datapath_5stage.webp]
Sơ đồ khối datapath 5 tầng


## Khối trong sơ đồ và module RTL tương ứng

| Tầng | Khối trong sơ đồ | Module RTL | Ghi chú |
| --- | --- | --- | --- |
| IF | PC, PC_Plus_4, Instruction_Memory | `IF_Stage` (`PC`, `PC_Plus_4`) | Instruction_Memory nằm ngoài lõi, nối qua `instr_addr` / `instr_rdata` (Boot ROM trong `SoC_Top`) |
| IF/ID | IF_ID_Reg | `IF_ID_Reg` | Giữ khi stall, chèn NOP khi flush |
| ID | Control_Unit, Register_File, Extend | `ID_Stage` (`Control_Unit` = `Main_Decoder` + `ALU_decoder`, `Register_File`, `Extend`) | Register_File ghi ở WB, có bypass ghi-đọc cùng chu kỳ |
| ID/EX | ID_EX_Reg | `ID_EX_Reg` | Flush thành bubble khi rẽ nhánh hoặc load-use |
| EX | ALU_Mux, ALU, Branch_Unit, PC_Target | `EX_Stage` (`ALU_Mux`, `ALU`, `Branch_Unit`, `PC_Target`) | Quyết định rẽ nhánh ở EX (`PCSrc_EX`) |
| EX/MEM | EX_MEM_Reg | `EX_MEM_Reg` | Mang thêm `funct3` cho load/store byte/half |
| MEM | Data_Memory | `MEM_Stage` | Data_Memory nằm ngoài lõi, nối qua `data_addr` / `data_wdata` / `data_wstrb` / `data_rdata` (bus AXI4-Lite trong `SoC_Top`). `MEM_Stage` lặp byte/half khi store và mở rộng dấu khi load |
| MEM/WB | MEM_WB_Reg | `MEM_WB_Reg` | |
| WB | Result_Mux | `WB_Stage` (`Result_Mux`) | Chọn ALU / dữ liệu load / PC+4 / PCTarget |
| — | Hazard_Unit | `Hazard_Detection` | Phát hiện load-use |
| — | Forwarding_Unit | `Forwarding_Unit` | ForwardA / ForwardB cho EX, ưu tiên MEM hơn WB |
| ID | (chưa có trong sơ đồ, P-09) | `Sys_Decoder` | Giải mã lệnh SYSTEM (Zicsr, ECALL, EBREAK, MRET, WFI) và phát hiện lệnh không hợp lệ. Lệnh không hợp lệ bị tắt mọi tác dụng (ghi thanh ghi, bộ nhớ, rẽ nhánh), chỉ gây trap khi tới MEM |
| IF/ID, ID/EX, EX/MEM | (chưa có trong sơ đồ, P-09) | `Pipe_Reg` | Thanh ghi phụ mang bit `valid`, thông tin CSR/trap và PC xuống MEM, cùng luật stall/flush với thanh ghi pipeline chính |
| MEM | (chưa có trong sơ đồ, P-09) | `CSR_Unit` | CSR máy (`mstatus`, `misa`, `mie`, `mip`, `mtvec`, `mscratch`, `mepc`, `mcause`, `mtval`, `mhartid`…) và quyết định trap trên lệnh ở MEM, gồm access fault khi `data_err` (P-24, `mcause` 5/7, `mtval` = địa chỉ) |

## Tín hiệu điều khiển pipeline (theo `RISCV_Core.v`)

| Tín hiệu | Nguồn | Tác dụng |
| --- | --- | --- |
| `LoadUseStall` | `Hazard_Detection` (load ở EX, lệnh ở ID đọc đúng thanh ghi đó) | Giữ PC và IF/ID, chèn bubble vào ID/EX |
| `PCSrc_EX` | `Branch_Unit` (nhánh lấy, JAL, JALR) | PC nhảy tới `PCTarget_EX`, flush IF/ID và ID/EX |
| `bus_stall` | Bên ngoài lõi (`SoC_Top`: `(data_we \| data_re) & ~resp_valid`) | Đóng băng toàn pipeline: PC, IF/ID, ID/EX, EX/MEM, MEM/WB |
| `instr_stall` | Bên ngoài lõi (R8, 07/11). `SoC_Top` nối 0 vì ROM trả dữ liệu ngay trong chu kỳ | `instr_rdata` chưa hợp lệ: giống stall load-use, PC và IF/ID giữ, ID/EX nhận bubble, EX/MEM/WB vẫn chạy. Redirect vẫn được ưu tiên |
| `ForwardA`, `ForwardB` | `Forwarding_Unit` | Chọn toán hạng EX từ thanh ghi, MEM (`ForwardResult_MEM`) hoặc WB (`Result_WB`) |
| `trap_redirect` | `CSR_Unit` (trap hoặc MRET ở MEM, chỉ khi không `bus_stall`) | PC nhảy tới `mtvec` (trap) hoặc `mepc` (MRET), flush IF/ID, ID/EX và biến lệnh rời EX thành bubble. Ưu tiên hơn `PCSrc_EX` |
| `trap_kill` | `CSR_Unit` (trap) | Hủy lệnh ở MEM: không ghi thanh ghi. Ngắt chỉ nhận trên lệnh hợp lệ không truy cập bộ nhớ, nên không giao dịch bus nào bị cắt hay lặp |
| `LoadUseStall` cho lệnh CSR | `Hazard_Detection` với `MemRead_EX \| csr_op_EX` | Lệnh CSR có kết quả ở MEM như lệnh load, lệnh phụ thuộc ngay sau chờ 1 chu kỳ |

## Điểm sơ đồ khác RTL (đề xuất khi vẽ lại)

Sơ đồ đúng ở mức khối. Các điểm sau đơn giản hóa so với RTL, nên sửa ở bản vẽ cho báo cáo cuối (Tuần 14–16):

1. **Nguồn stall/flush:** sơ đồ cho Hazard_Unit điều khiển tất cả thanh ghi pipeline. Trong RTL, `Hazard_Detection` chỉ tạo `LoadUseStall`. Flush khi rẽ nhánh đến từ `Branch_Unit` (`PCSrc_EX`), còn đóng băng EX/MEM và MEM/WB đến từ `bus_stall` bên ngoài lõi.
2. **Thiếu đường hồi tiếp:** EX → IF (`PCTarget_EX`, `PCSrc_EX`), WB → Register_File (`Result_WB`, `Rd_WB`, `RegWrite_WB`), và dữ liệu forward từ EX/MEM, MEM/WB về EX.
3. **Bộ nhớ:** Instruction_Memory và Data_Memory vẽ trong tầng IF và MEM. Trong RTL hai khối này nằm ngoài lõi (Boot ROM và bus AXI4-Lite của `SoC_Top`), nên vẽ ở mép tầng, nối qua cổng của lõi.
4. **Nhãn sót:** mũi tên MEM → MEM_WB_Reg còn chữ "Text".
5. **Đầu vào của Hazard_Unit và Forwarding_Unit** (`MemRead_EX`, `Rd_EX`, `Rs1/Rs2`, `Rd_MEM`, `Rd_WB`, `RegWrite_*`) chưa vẽ.
6. **Phần P-09 (26/10):** `Sys_Decoder`, `CSR_Unit`, các `Pipe_Reg` phụ, cổng `irq_timer`/`irq_ext` và đường `trap_redirect` về IF chưa có trong hình. Cổng `data_err` vào `CSR_Unit` (P-24, 04/11) cũng chưa có.

Từ 05/11 có bản vẽ mới ở mức khối: trang 04 của bộ sơ đồ (`docs/diagrams/png/04_master_core.png`, Nguyên vẽ cho N-31, sinh từ `docs/diagrams/gen/pg_arch2.py`). Trang này đã giải quyết điểm 1 (Hazard_Detection chỉ giữ PC và chèn bubble, `bus_stall` vẽ riêng), điểm 3 (bộ nhớ lệnh và cổng dữ liệu nằm ngoài lõi), điểm 4 và điểm 6 (Sys_Decoder, CSR_Unit, `irq_timer`/`irq_ext`, redirect của trap và MRET, `data_err`), chỉ chưa vẽ các `Pipe_Reg` phụ. Điểm 2 và 5 (đường hồi tiếp EX → IF, WB → Register_File, dữ liệu forward, đầu vào của Hazard_Detection và Forwarding_Unit) trang 04 mới ghi bằng chữ. Báo cáo dùng trang 04 cho hình mức khối, chỉ cần vẽ thêm nếu muốn một hình mức tín hiệu.
