NguyenDinhNhatNguyen/HRoT_SoC/docs/diagrams/png/01_system_overview.png

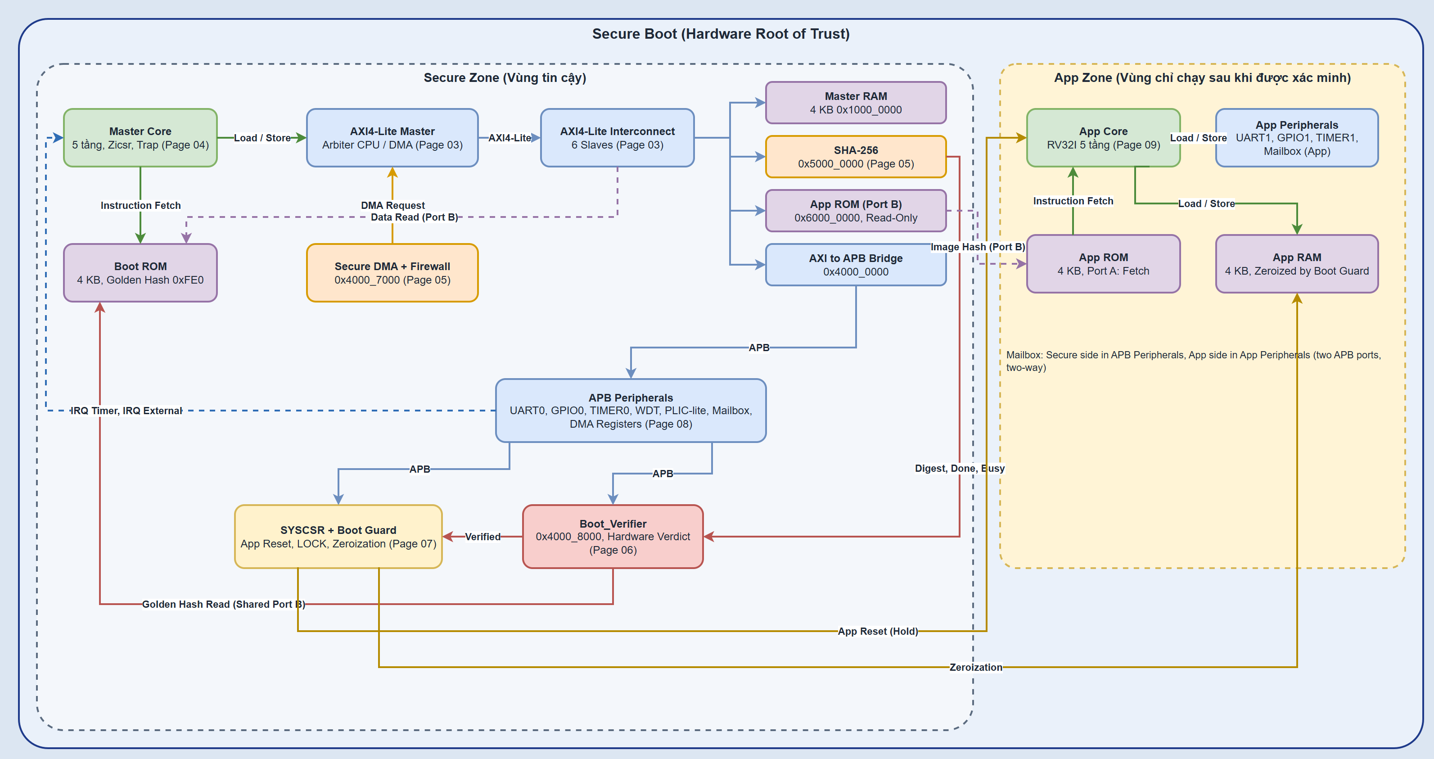
docs/diagrams/png/01_system_overview.png
