NguyenDinhNhatNguyen/HRoT_SoC/docs/diagrams/png/02_memory_map.png

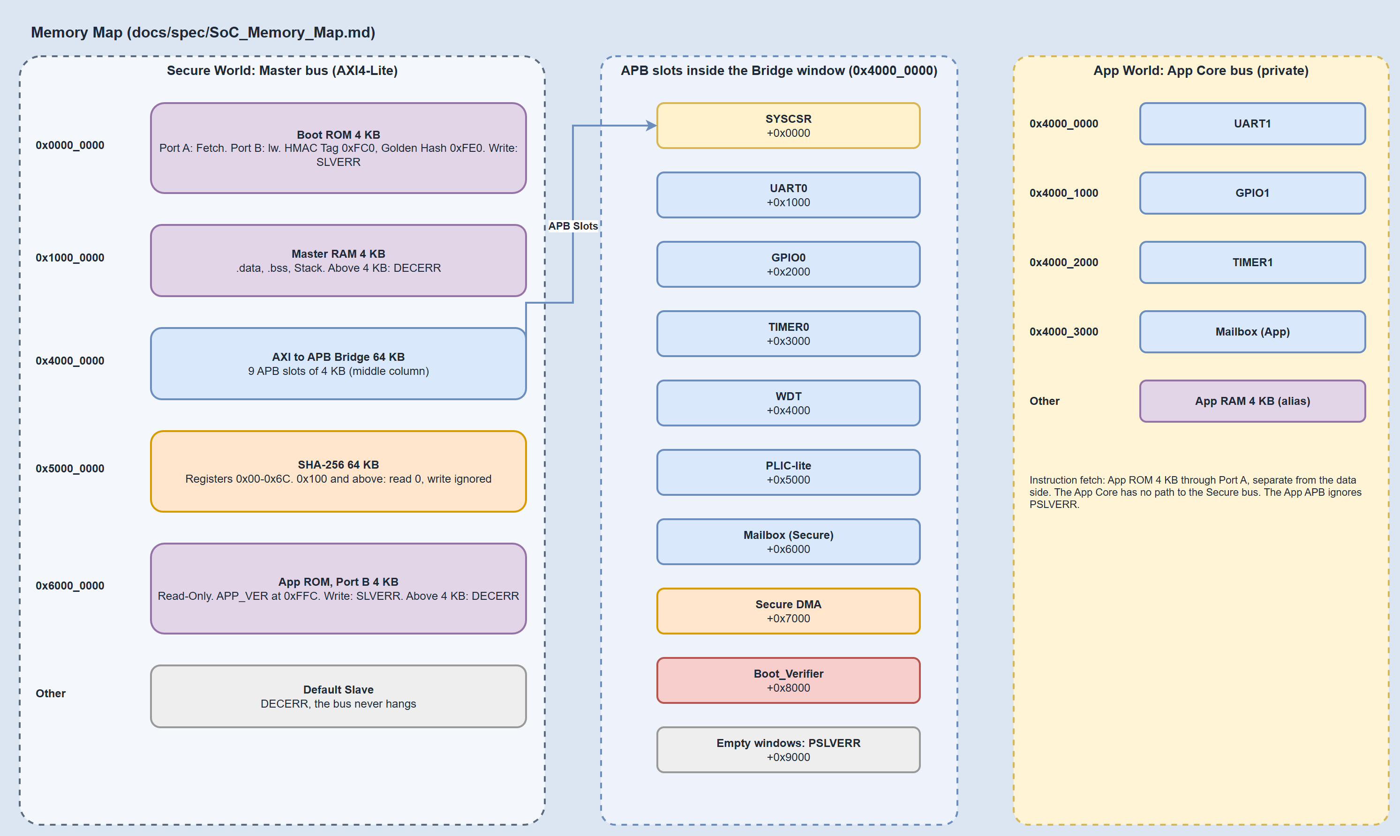
docs/diagrams/png/02_memory_map.png
