NguyenDinhNhatNguyen/HRoT_SoC/docs/diagrams/png/03_secure_bus_fabric.png

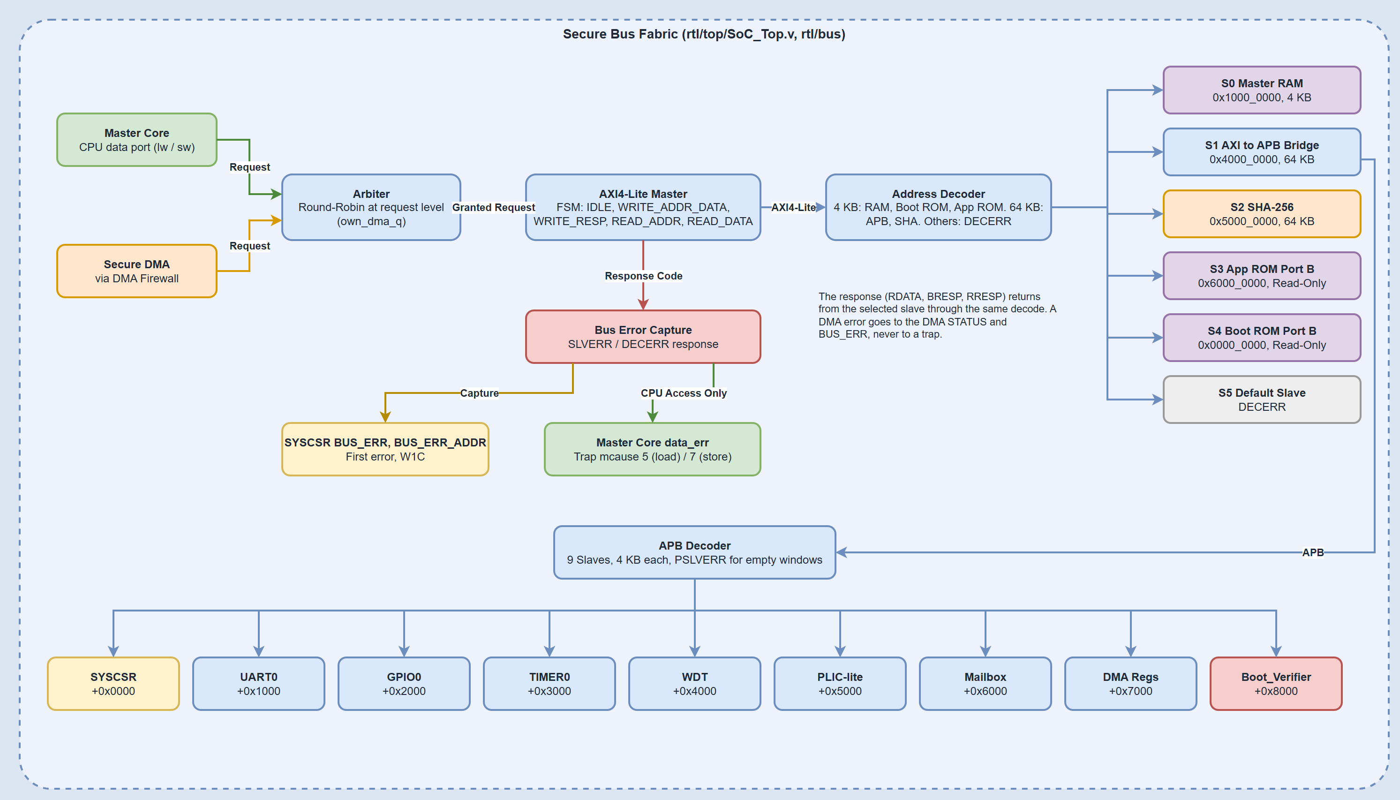
docs/diagrams/png/03_secure_bus_fabric.png
