NguyenDinhNhatNguyen/HRoT_SoC/docs/diagrams/png/04_master_core.png

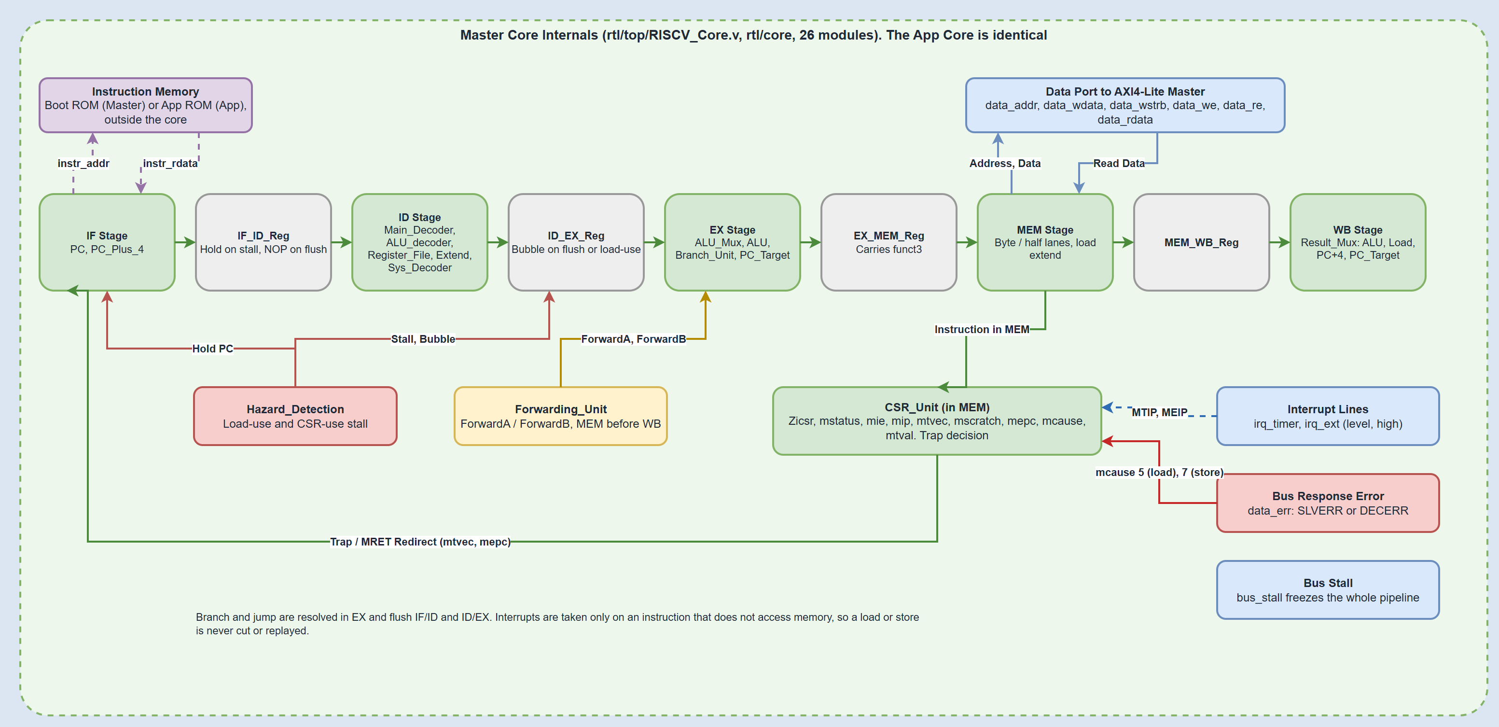
docs/diagrams/png/04_master_core.png
