NguyenDinhNhatNguyen/HRoT_SoC/docs/diagrams/png/05_secure_dma_firewall_sha_256.png

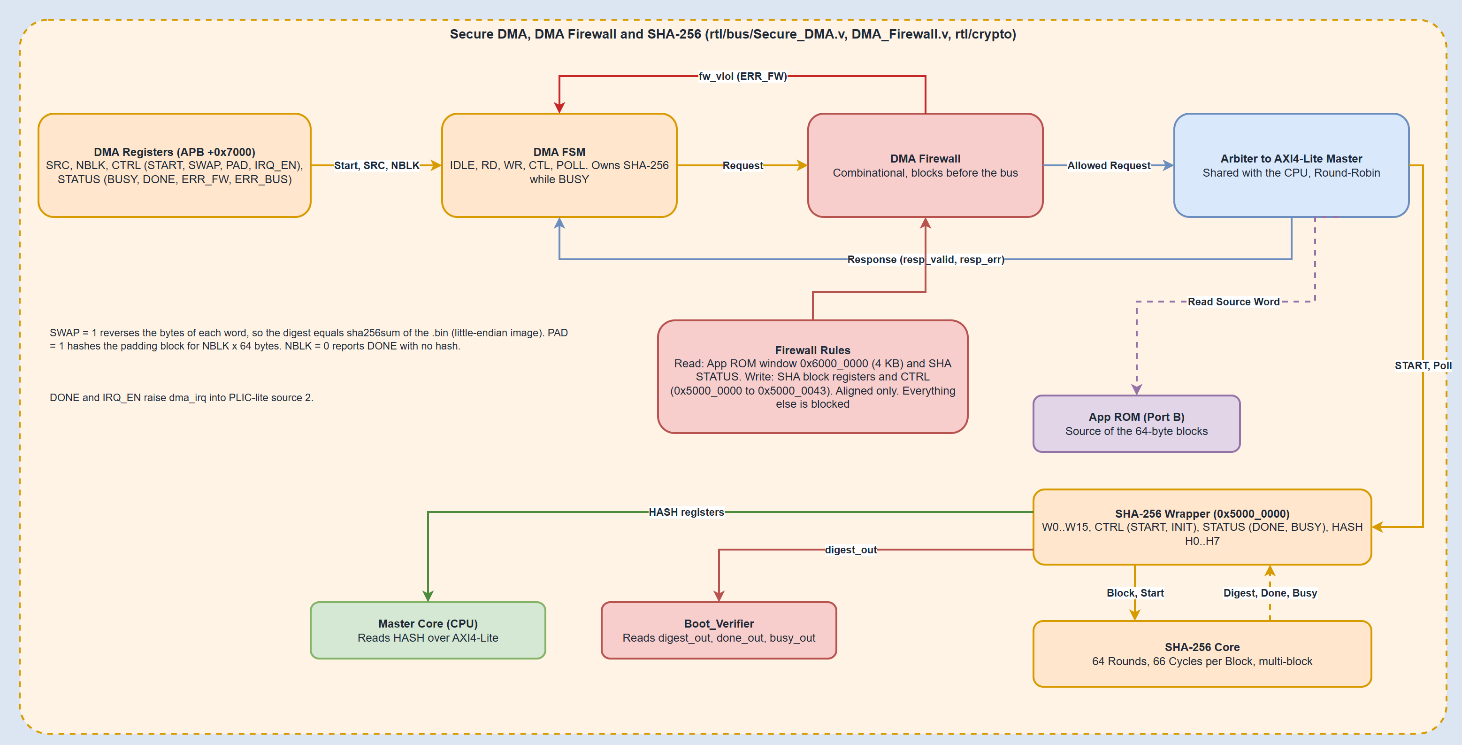
docs/diagrams/png/05_secure_dma_firewall_sha_256.png
