NguyenDinhNhatNguyen/HRoT_SoC/docs/diagrams/png/07_syscsr_and_boot_guard.png

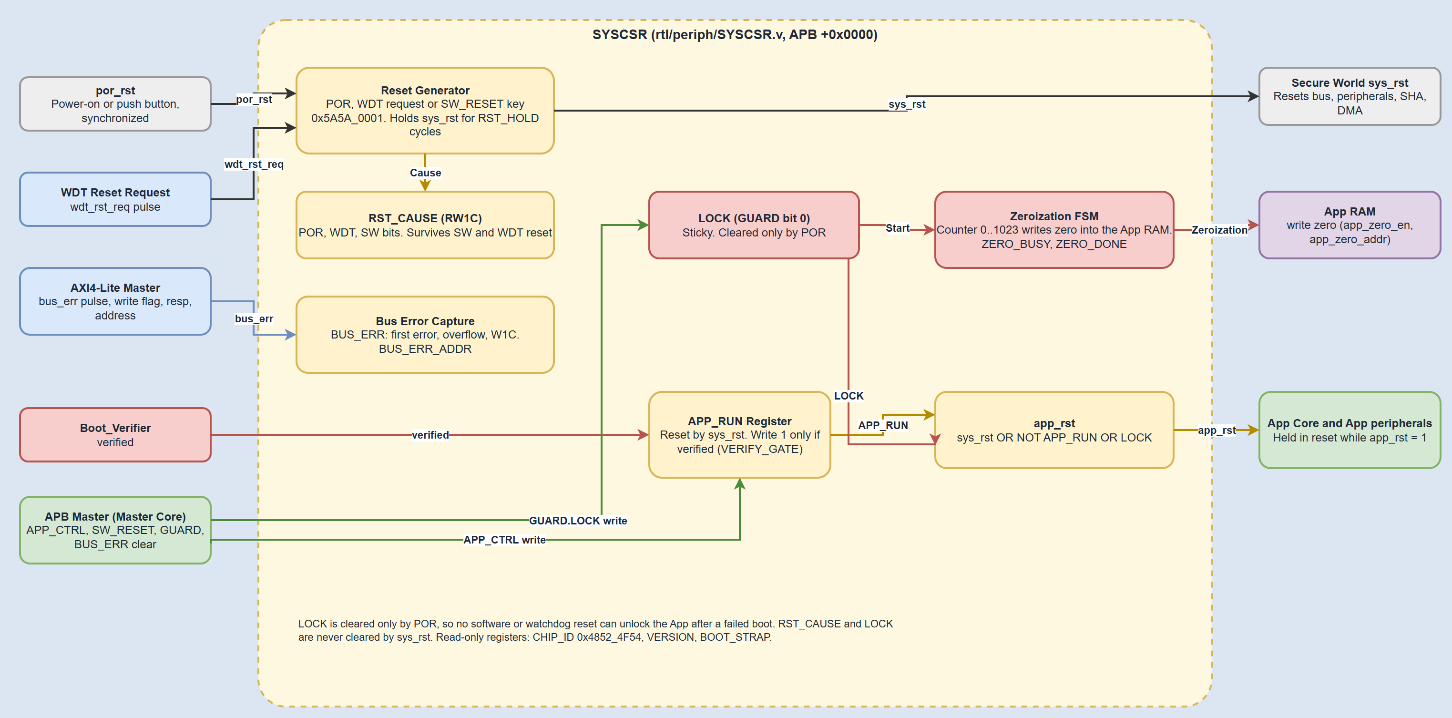
docs/diagrams/png/07_syscsr_and_boot_guard.png
