NguyenDinhNhatNguyen/HRoT_SoC/docs/diagrams/png/08_secure_peripherals_and_interrupts.png

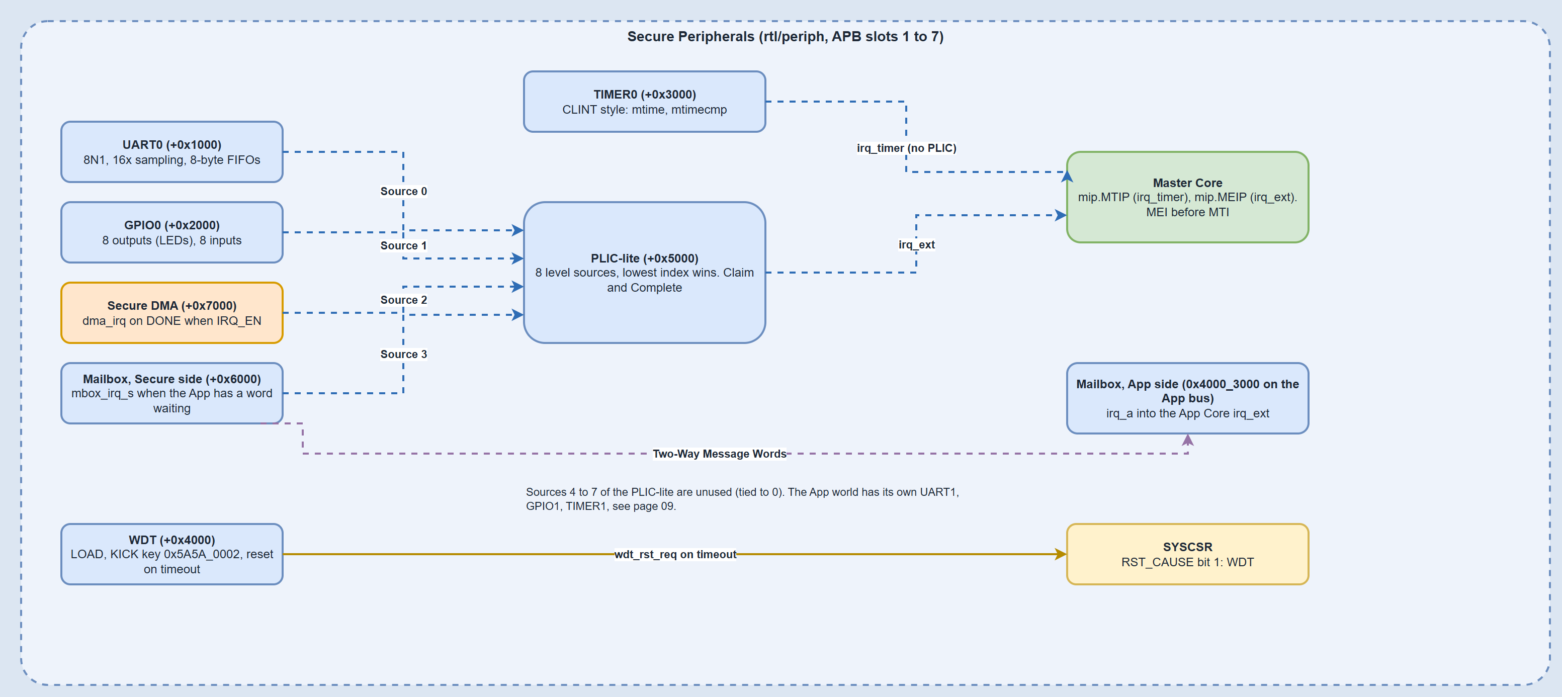
docs/diagrams/png/08_secure_peripherals_and_interrupts.png
