NguyenDinhNhatNguyen/HRoT_SoC/docs/diagrams/png/09_app_world.png

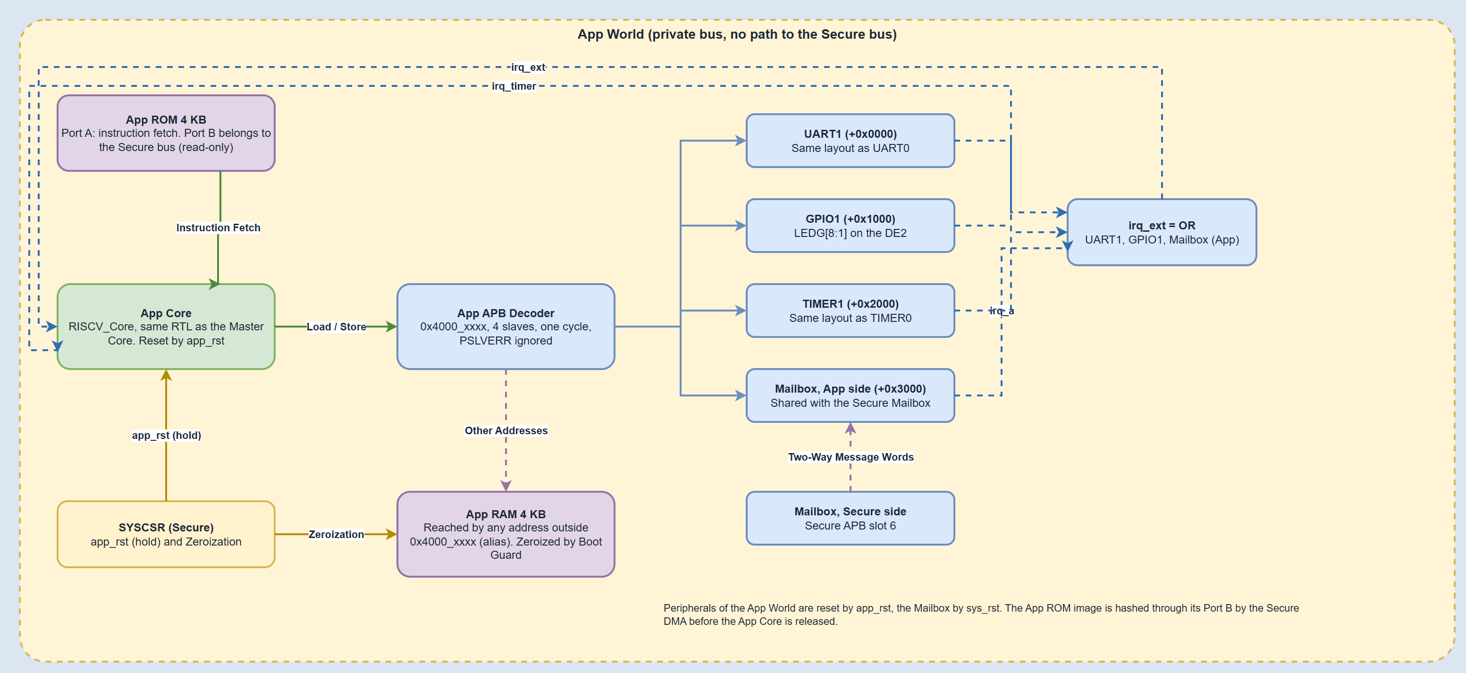
docs/diagrams/png/09_app_world.png
