NguyenDinhNhatNguyen/HRoT_SoC/docs/diagrams/png/10_security_architecture.png

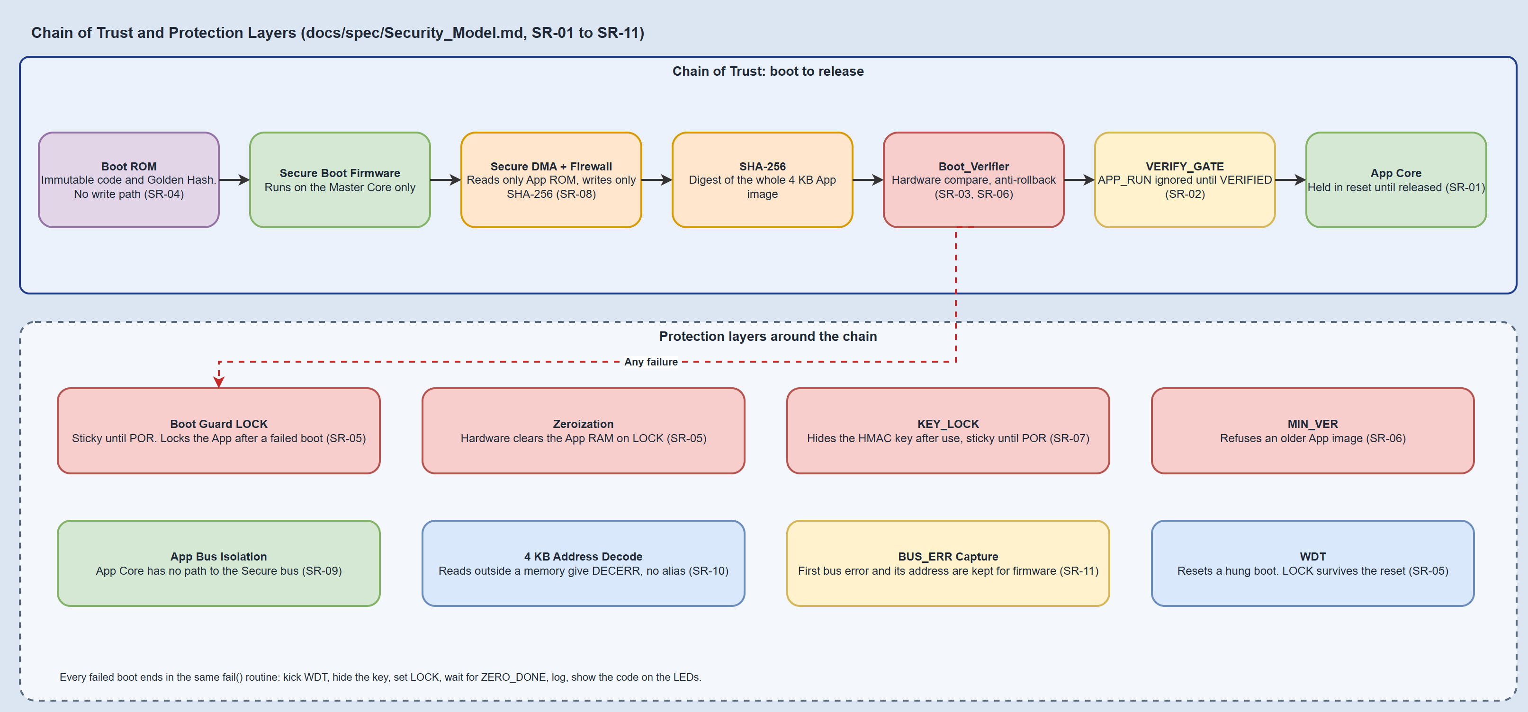
docs/diagrams/png/10_security_architecture.png
