NguyenDinhNhatNguyen/HRoT_SoC/docs/diagrams/png/11_secure_boot_flow.png

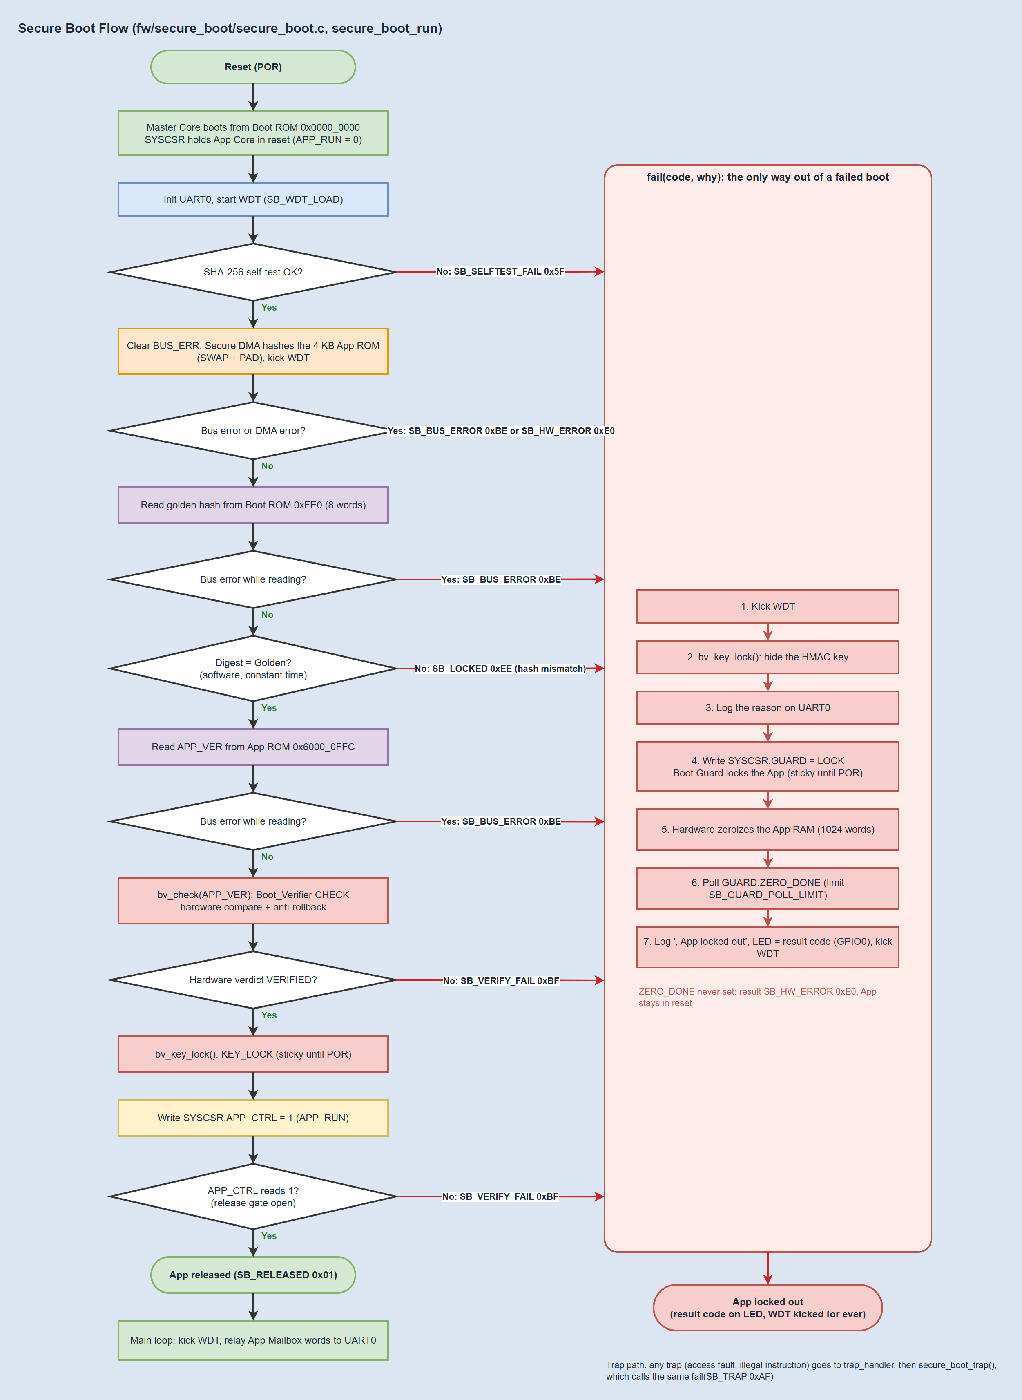
docs/diagrams/png/11_secure_boot_flow.png
