NguyenDinhNhatNguyen/HRoT_SoC/docs/diagrams/png/12_tamper_and_lockdown_flow.png

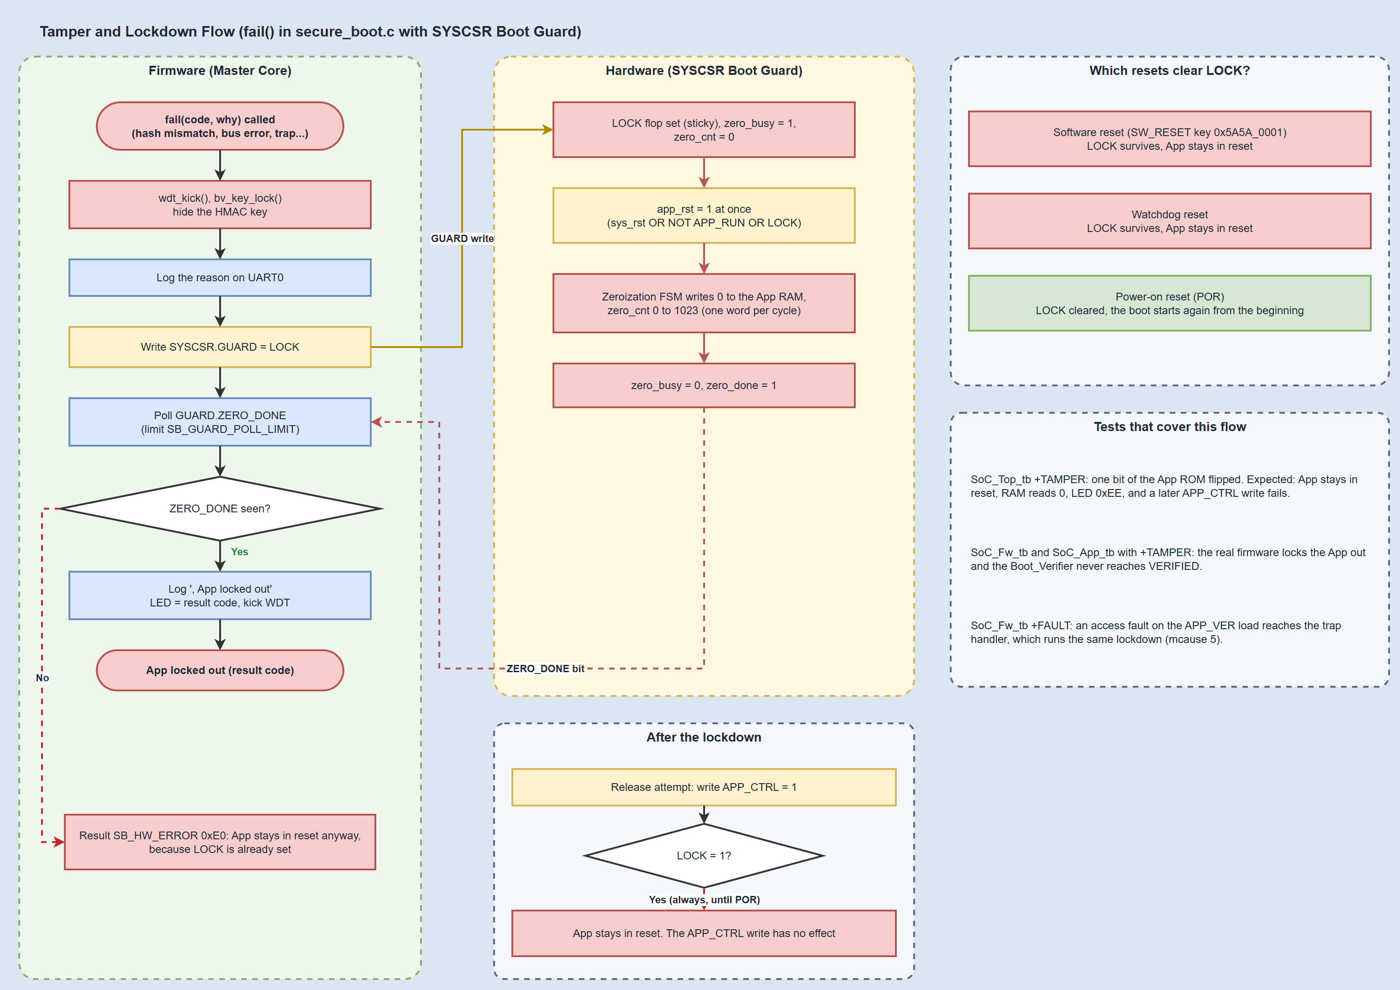
docs/diagrams/png/12_tamper_and_lockdown_flow.png
