NguyenDinhNhatNguyen/HRoT_SoC/docs/diagrams/png/14_secure_dma_fsm_and_firewall_decision.png

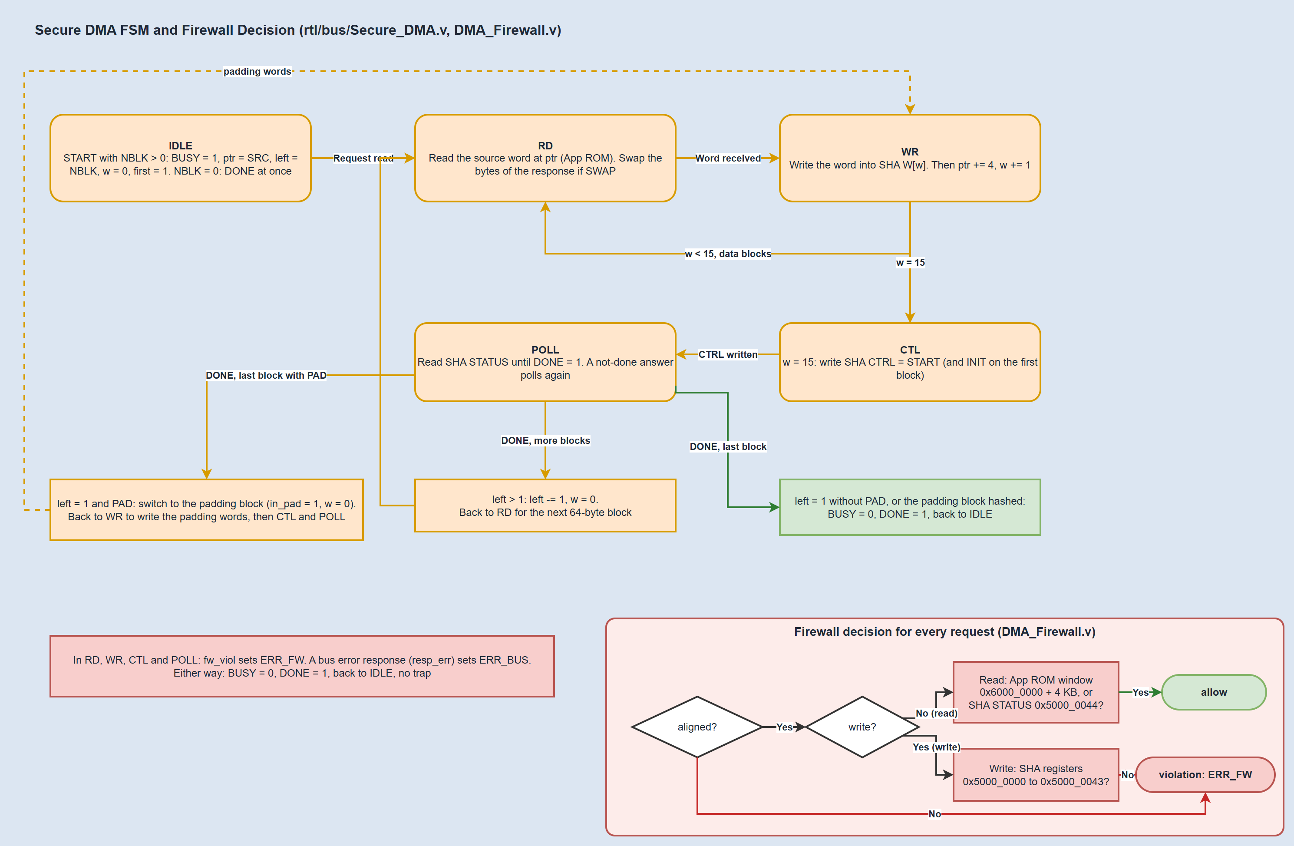
docs/diagrams/png/14_secure_dma_fsm_and_firewall_decision.png
