NguyenDinhNhatNguyen/HRoT_SoC/docs/diagrams/png/15_bus_transaction_and_error_flow.png

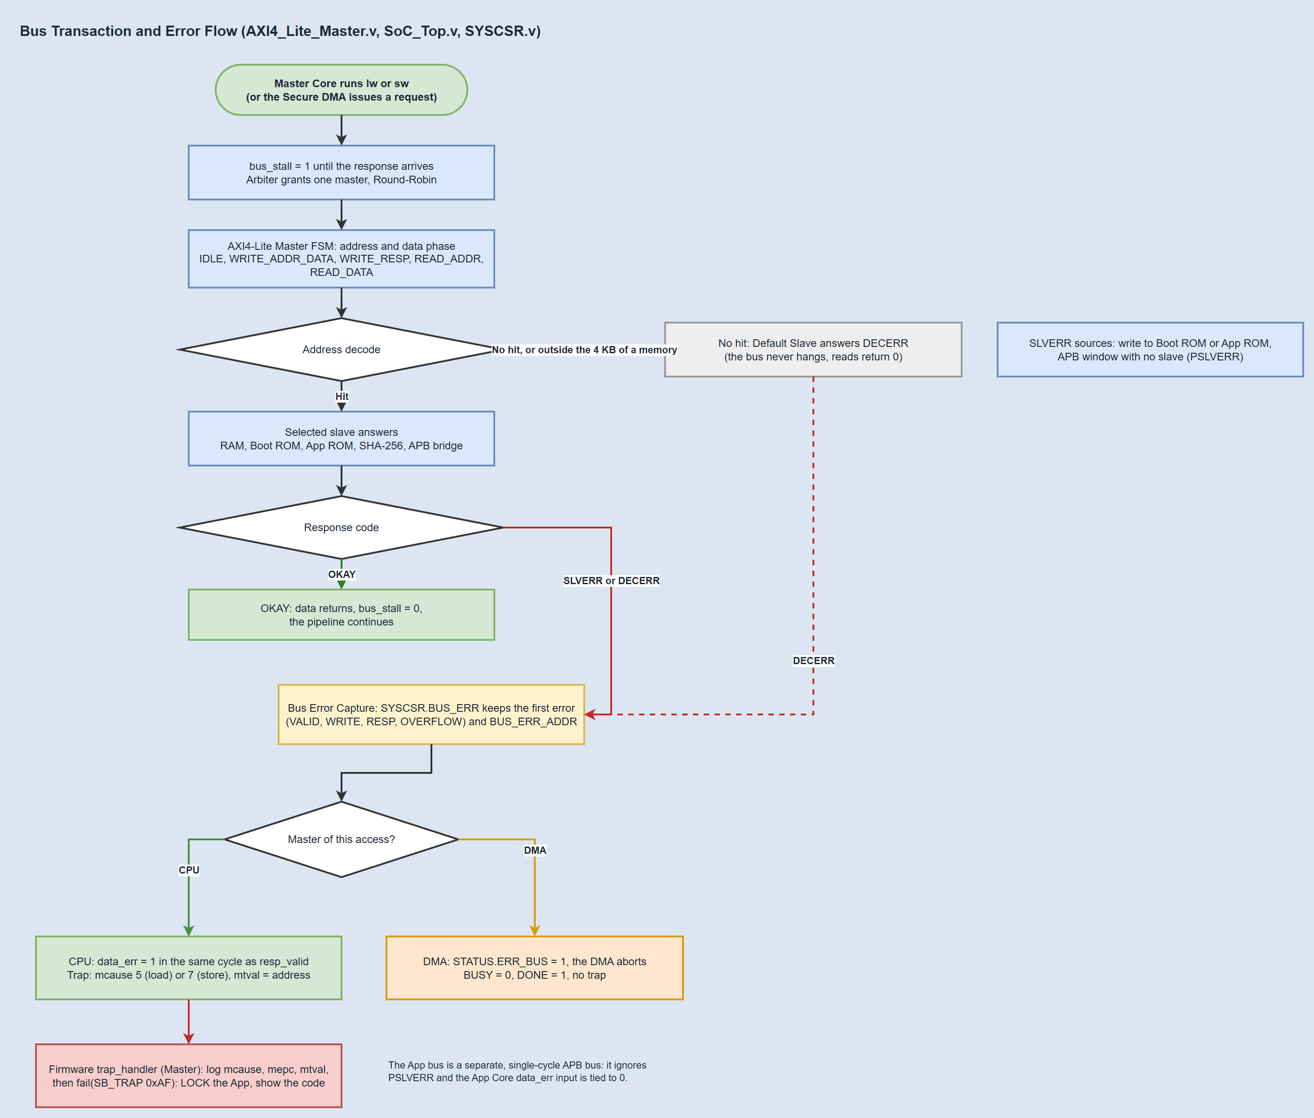
docs/diagrams/png/15_bus_transaction_and_error_flow.png
