NguyenDinhNhatNguyen/HRoT_SoC/docs/diagrams/png/16_interrupt_and_trap_flow.png

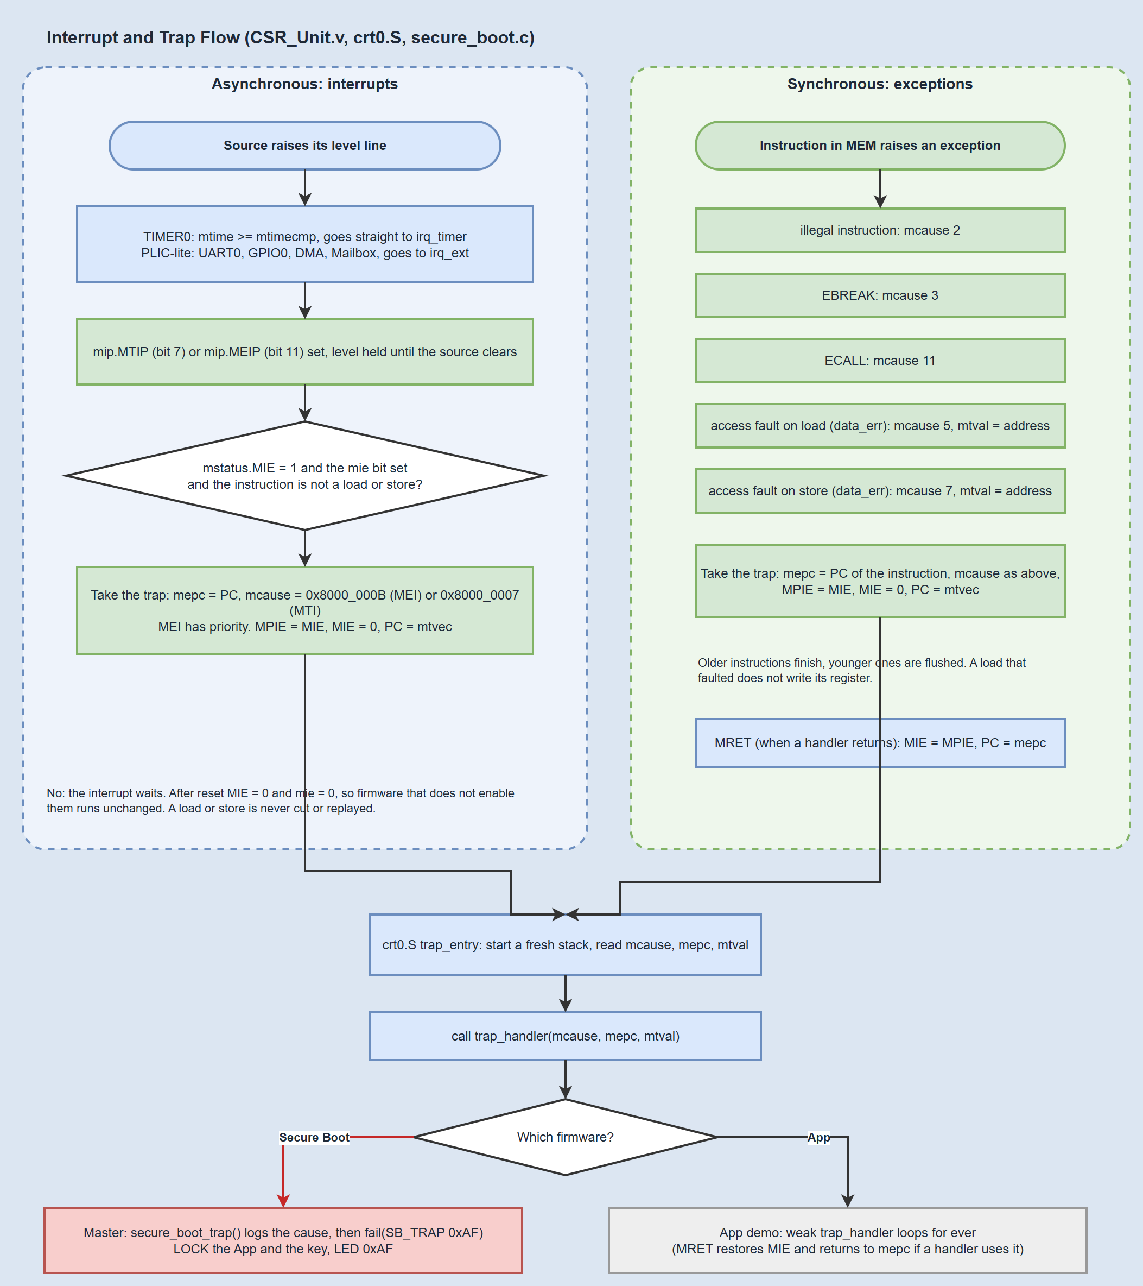
docs/diagrams/png/16_interrupt_and_trap_flow.png
