NguyenDinhNhatNguyen/HRoT_SoC/docs/diagrams/png/17_reset_and_power_flow.png

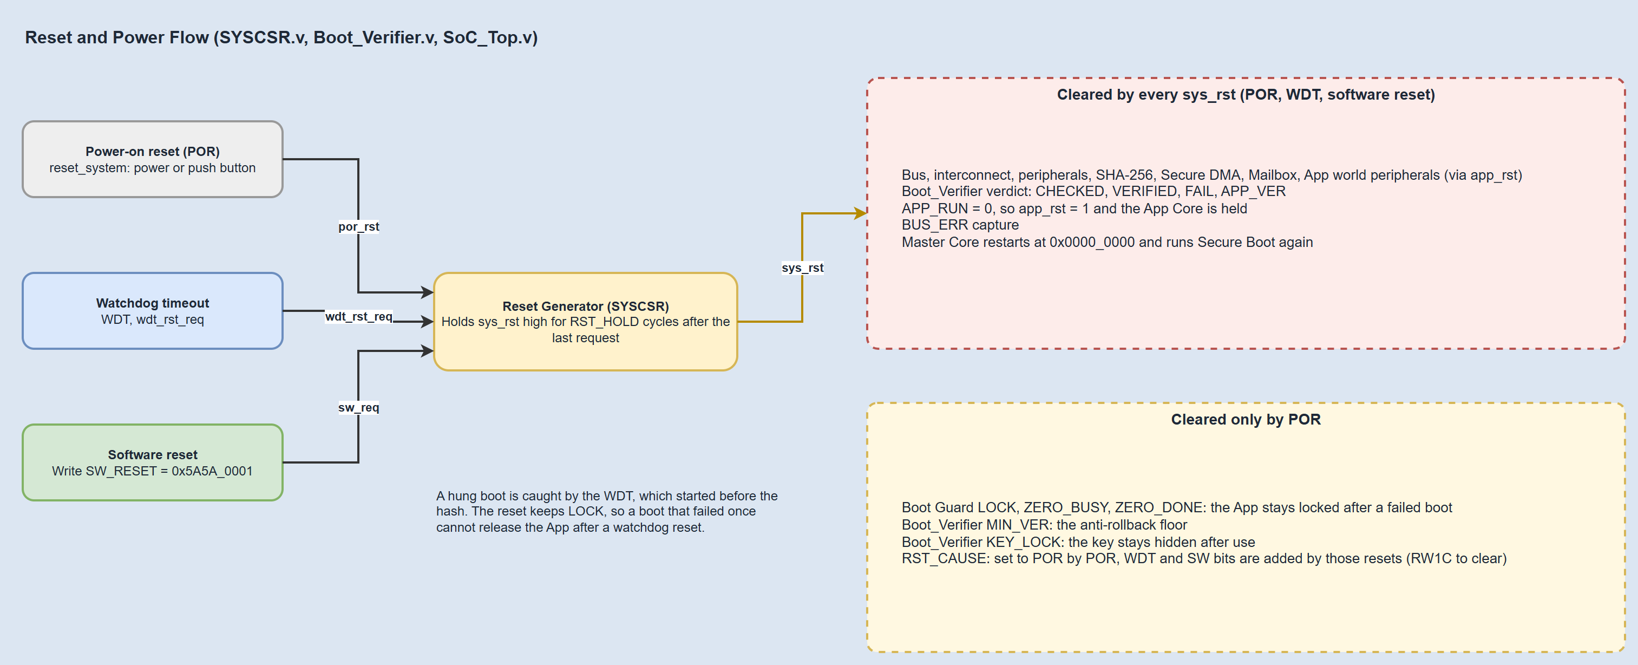
docs/diagrams/png/17_reset_and_power_flow.png
