NguyenDinhNhatNguyen/HRoT_SoC/docs/diagrams/png/19_kv260_pmod_j2.png

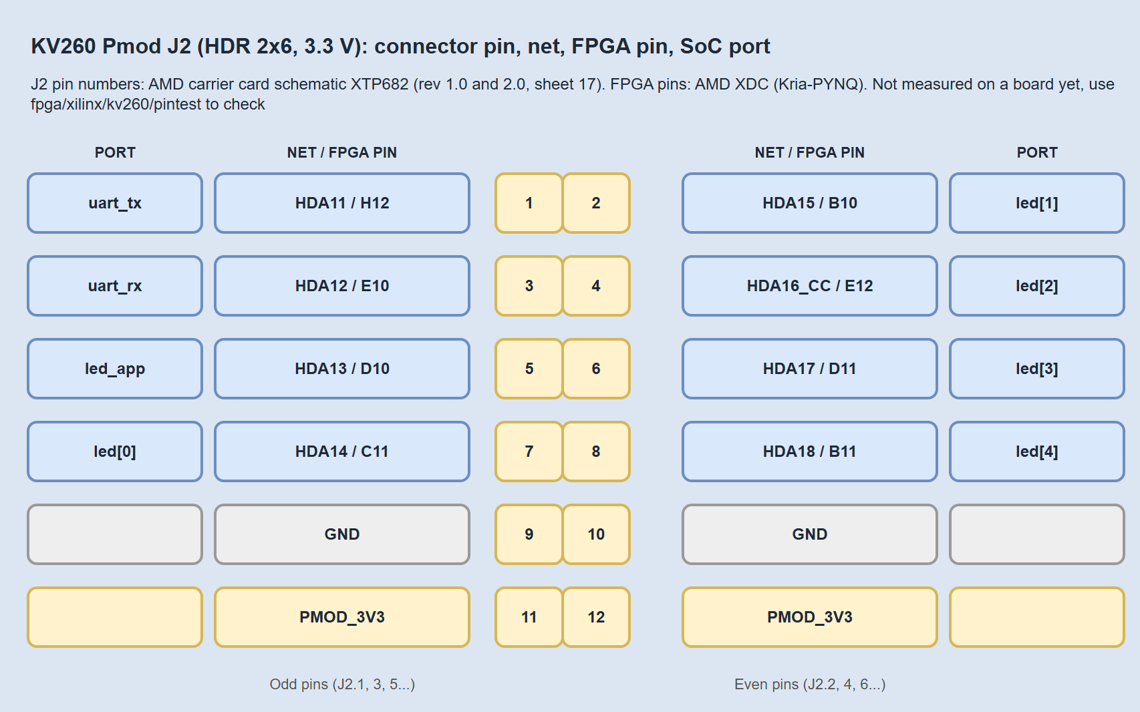
docs/diagrams/png/19_kv260_pmod_j2.png
