NguyenDinhNhatNguyen/HRoT_SoC/docs/diagrams/png/20_vp_architecture.png

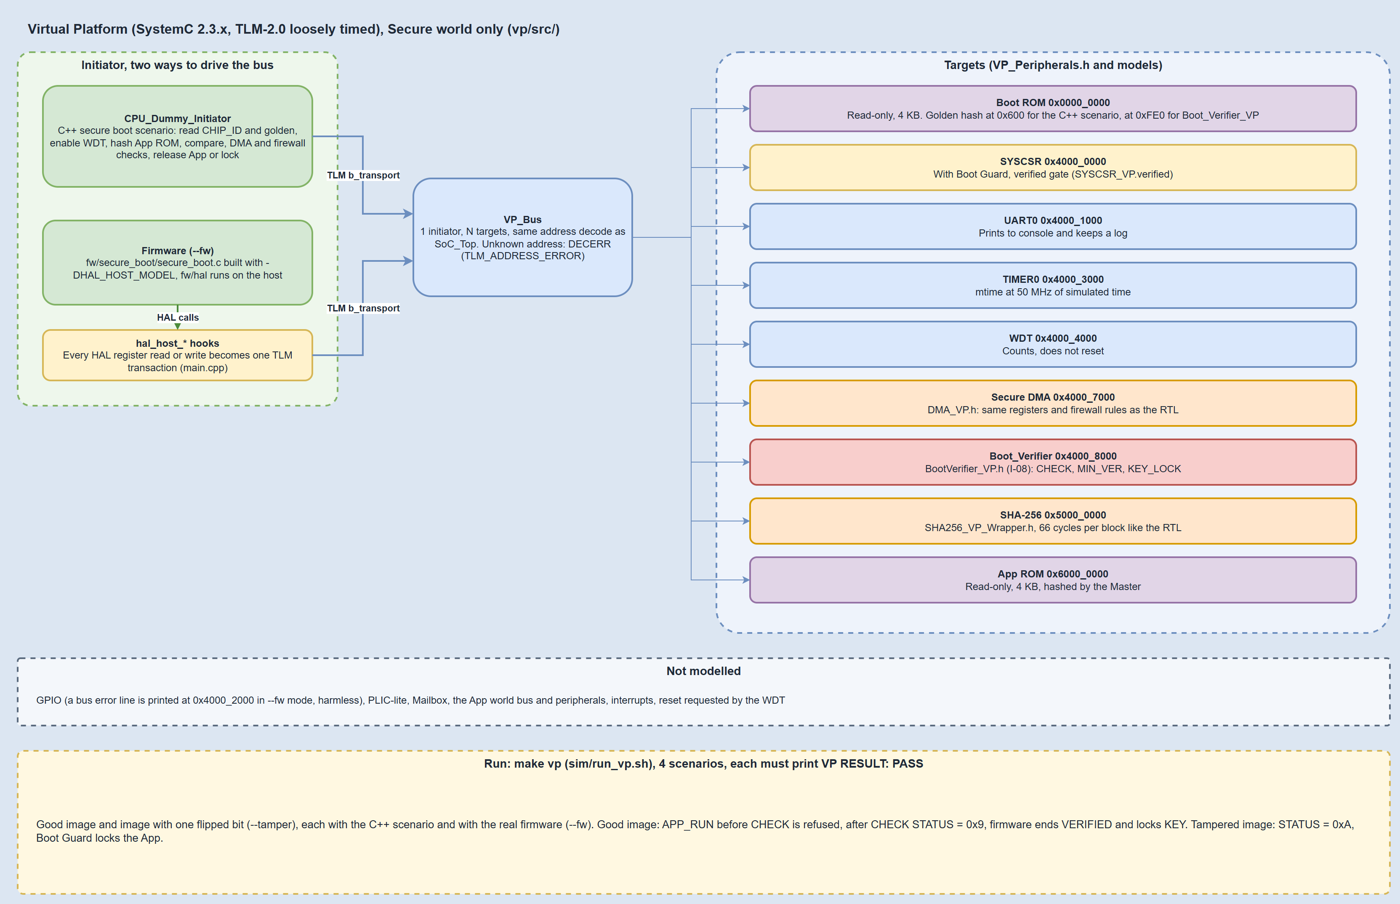
docs/diagrams/png/20_vp_architecture.png
