NguyenDinhNhatNguyen/HRoT_SoC/docs/diagrams/png/06_boot_verifier.png

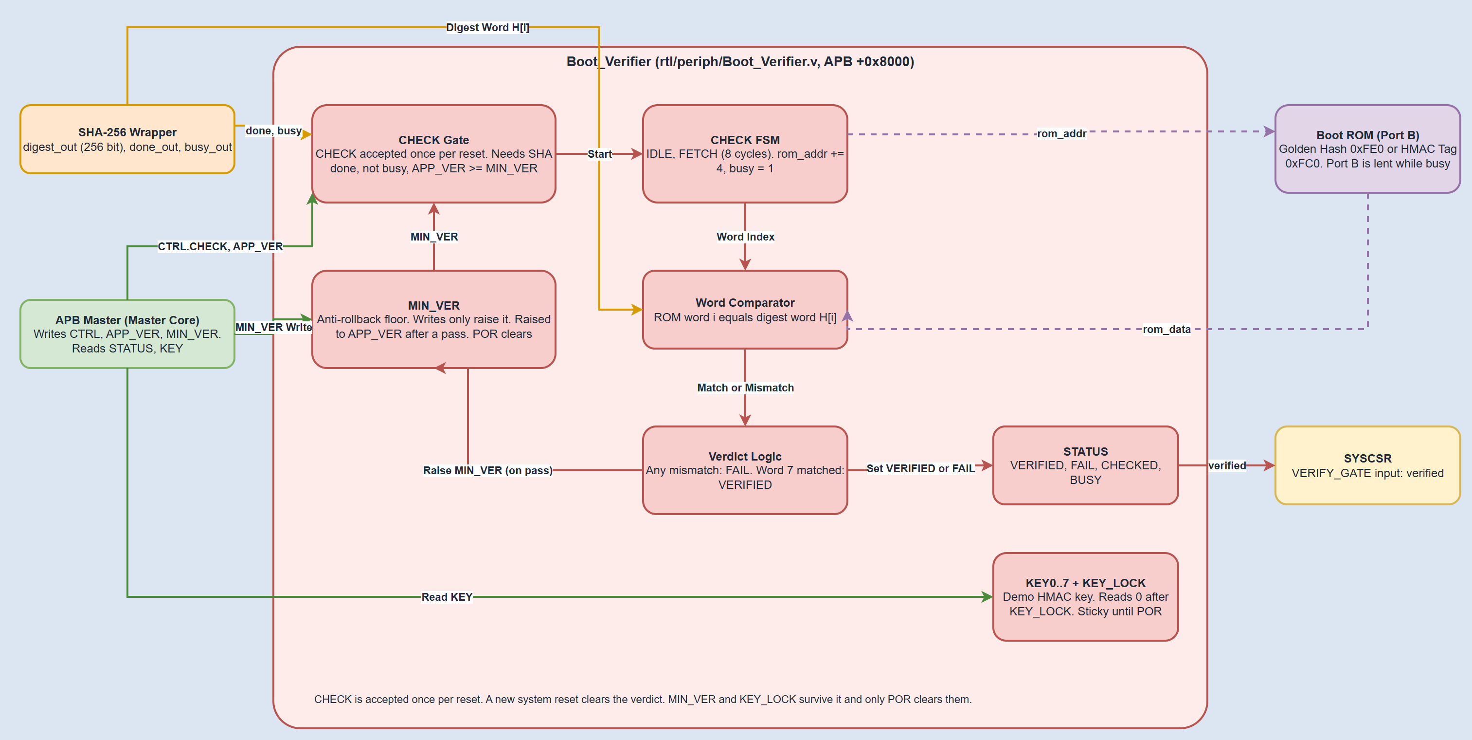
docs/diagrams/png/06_boot_verifier.png
