NguyenDinhNhatNguyen/HRoT_SoC/docs/diagrams/png/13_boot_verifier_check_fsm.png

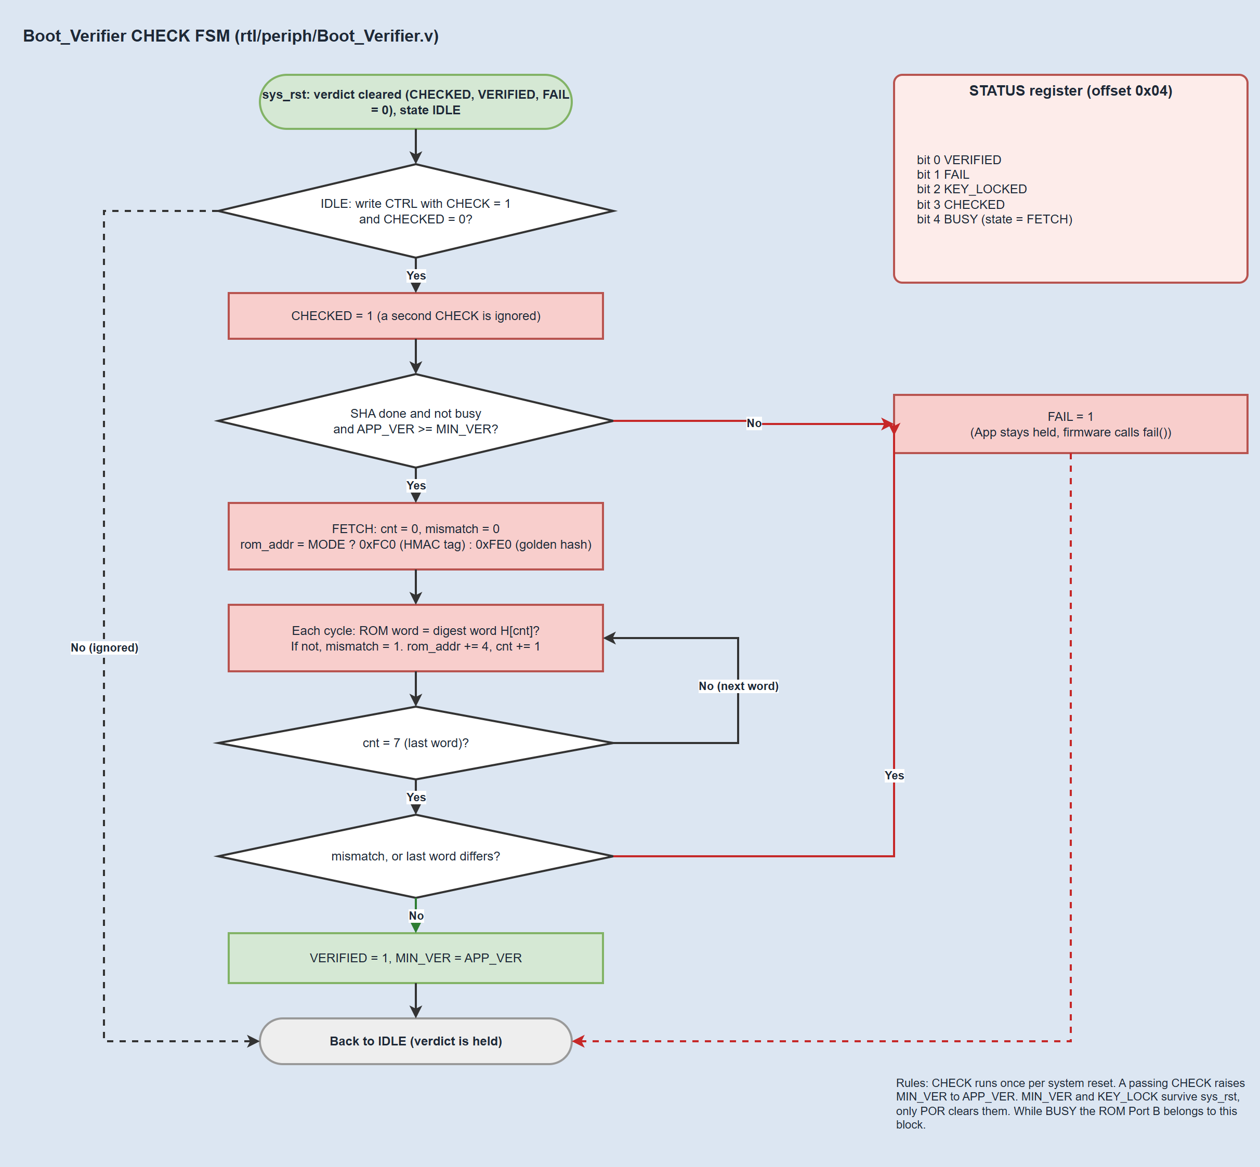
docs/diagrams/png/13_boot_verifier_check_fsm.png
