NguyenDinhNhatNguyen/HRoT_SoC/docs/diagrams/png/18_verification_flow.png

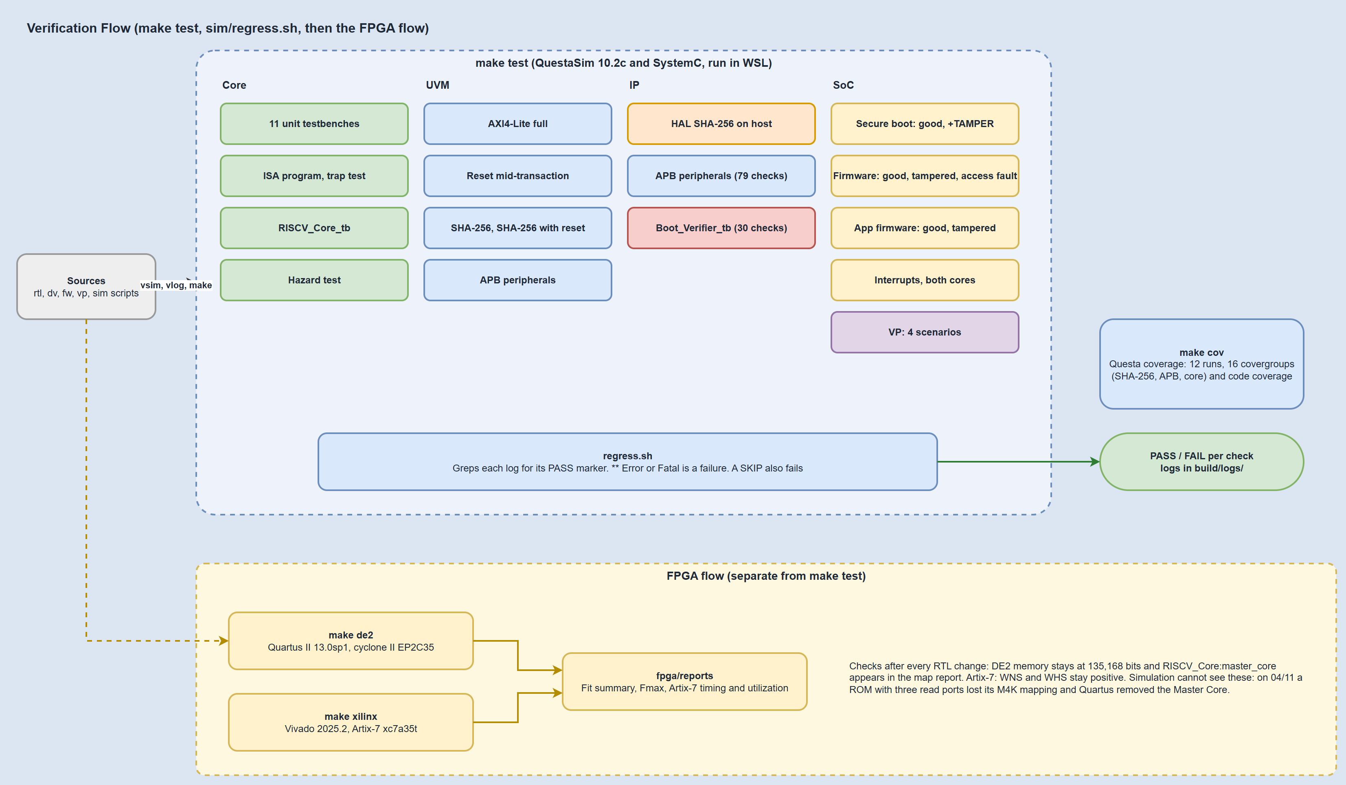
docs/diagrams/png/18_verification_flow.png
