NguyenDinhNhatNguyen/HRoT_SoC/docs/diagrams/png/21_fpga_testbed.png

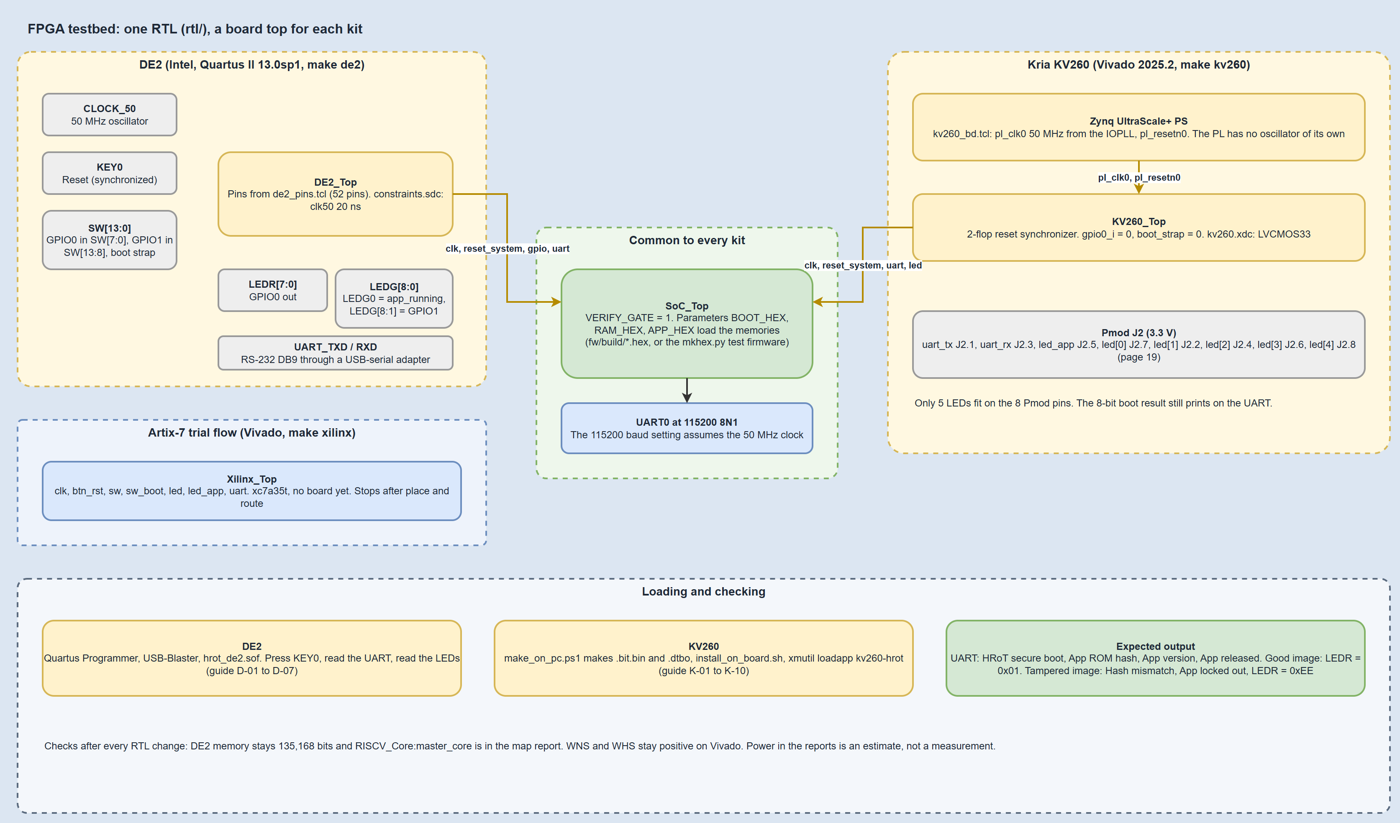
docs/diagrams/png/21_fpga_testbed.png
