NguyenDinhNhatNguyen/HRoT_SoC/rtl/bus/AXI4_Lite_Master.v

`timescale 1ns / 1ps

// AXI4-Lite master: turns one load/store request from the core into a single AXI transaction.
// One transaction in flight at a time. resp_valid pulses for one cycle when it completes.
module AXI4_Lite_Master (
    input             clk, reset,
    
    input             req_valid,
    input             req_write,
    input      [31:0] req_addr,
    input      [31:0] req_wdata,
    input      [3:0]  req_wstrb,     // write byte lanes (core's data_wstrb)
    output reg        req_ready,
    output reg        resp_valid,
    output reg [31:0] resp_rdata,
    output reg        err_valid,     // one-cycle pulse: the transaction just finished with SLVERR or DECERR
    output reg        err_write,     // 1 = that transaction was a write
    output reg [1:0]  err_resp,      // its BRESP or RRESP
    output reg [31:0] err_addr,      // its address

    // AXI Write Address Channel
    output reg        M_AXI_AWVALID,
    input             M_AXI_AWREADY,
    output reg [31:0] M_AXI_AWADDR,
    
    // AXI Write Data Channel
    output reg        M_AXI_WVALID,
    input             M_AXI_WREADY,
    output reg [31:0] M_AXI_WDATA,
    output reg [3:0]  M_AXI_WSTRB,
    
    // AXI Write Response Channel
    input             M_AXI_BVALID,
    output reg        M_AXI_BREADY,
    input      [1:0]  M_AXI_BRESP,
    
    // AXI Read Address Channel
    output reg        M_AXI_ARVALID,
    input             M_AXI_ARREADY,
    output reg [31:0] M_AXI_ARADDR,
    
    // AXI Read Data Channel
    input             M_AXI_RVALID,
    output reg        M_AXI_RREADY,
    input      [31:0] M_AXI_RDATA,
    input      [1:0]  M_AXI_RRESP
);

    // Master FSM
    localparam IDLE = 0, WRITE_ADDR_DATA = 1, WRITE_RESP = 2, READ_ADDR = 3, READ_DATA = 4;
    reg [2:0] state;

    always @(posedge clk) begin
        if (reset) begin
            state         <= IDLE; 
            req_ready     <= 1; 
            resp_valid    <= 0;
            resp_rdata    <= 0;
            M_AXI_AWVALID <= 0; 
            M_AXI_WVALID  <= 0; 
            M_AXI_BREADY  <= 0;
            M_AXI_ARVALID <= 0; 
            M_AXI_RREADY  <= 0;
            err_valid     <= 0;
            err_write     <= 0;
            err_resp      <= 2'b00;
            err_addr      <= 32'b0;
        end else begin
            err_valid <= 0;
            case (state)
                IDLE: begin
                    resp_valid <= 0;
                    // While resp_valid is high the old instruction is still in MEM, so don't reissue it
                    if (req_valid && req_ready && !resp_valid) begin
                        req_ready <= 0;
                        if (req_write) begin
                            M_AXI_AWADDR  <= req_addr; 
                            M_AXI_WDATA   <= req_wdata;
                            M_AXI_WSTRB   <= req_wstrb;
                            M_AXI_AWVALID <= 1; 
                            M_AXI_WVALID  <= 1;
                            state         <= WRITE_ADDR_DATA;
                        end else begin
                            M_AXI_ARADDR  <= req_addr; 
                            M_AXI_ARVALID <= 1;
                            state         <= READ_ADDR;
                        end
                    end
                end
                
                // Write: AW and W can be accepted in either order
                WRITE_ADDR_DATA: begin
                    if (M_AXI_AWREADY)
                        M_AXI_AWVALID <= 0;
                    if (M_AXI_WREADY)
                        M_AXI_WVALID <= 0;
                    
                    if (!M_AXI_AWVALID && !M_AXI_WVALID) begin
                        M_AXI_BREADY <= 1; 
                        state        <= WRITE_RESP;
                    end
                end
                
                WRITE_RESP: begin
                    if (M_AXI_BVALID) begin
                        if (M_AXI_BRESP != 2'b00) begin
                            err_valid <= 1;
                            err_write <= 1;
                            err_resp  <= M_AXI_BRESP;
                            err_addr  <= M_AXI_AWADDR;
                        end
                        M_AXI_BREADY <= 0; 
                        resp_valid   <= 1; 
                        req_ready    <= 1; 
                        state        <= IDLE;
                    end
                end
                
                // Read
                READ_ADDR: begin
                    if (M_AXI_ARREADY) begin
                        M_AXI_ARVALID <= 0; 
                        M_AXI_RREADY  <= 1; 
                        state         <= READ_DATA;
                    end
                end
                
                READ_DATA: begin
                    if (M_AXI_RVALID) begin
                        if (M_AXI_RRESP != 2'b00) begin
                            err_valid <= 1;
                            err_write <= 0;
                            err_resp  <= M_AXI_RRESP;
                            err_addr  <= M_AXI_ARADDR;
                        end
                        resp_rdata   <= M_AXI_RDATA; 
                        M_AXI_RREADY <= 0;
                        resp_valid   <= 1; 
                        req_ready    <= 1; 
                        state        <= IDLE;
                    end
                end
            endcase
        end
    end
endmodule
