NguyenDinhNhatNguyen/HRoT_SoC/rtl/mem/Dual_Port_ROM.v

`timescale 1ns / 1ps

// 4 KB read-only ROM, used as the Boot ROM and as the App ROM
// - Port A: instruction fetch (Master Core for the Boot ROM, App Core for the App ROM)
// - Port B: read-only AXI slave on the Master bus (loads, and hashing the App image).
//   SoC_Top also lends it to Boot_Verifier while a CHECK runs. A third read port would stop
//   Quartus from mapping the ROM to M4K and the whole core behind it was optimised away
module Dual_Port_ROM #(
    parameter INIT_FILE = "../fw/build/app_firmware.hex"
)(
    input             clk,
    // Port A: App Core fetch
    input      [31:0] addrA,
    output reg [31:0] dataOutA,

    // Port B: Master Core reads (over AXI)
    input      [31:0] addrB,
    output reg [31:0] dataOutB
);
    // 4 KB (1024 x 32-bit words)
    reg [31:0] rom [0:1023];

    initial begin
        $readmemh(INIT_FILE, rom);
    end

    // Falling-edge synchronous read (same scheme as Data_Memory): maps to a dual-read-port M4K/BRAM
    // while the core still gets the instruction in the same cycle as its PC. The read path has
    // half a cycle (10 ns at 50 MHz). Addresses are byte addresses, hence the >> 2.
    always @(negedge clk) begin
        dataOutA <= rom[addrA[11:2]];
        dataOutB <= rom[addrB[11:2]];
    end
endmodule
