NguyenDinhNhatNguyen/HRoT_SoC/dv/hrot_dv_pkg.sv

`timescale 1ns/1ps
// All UVM classes in one package. Compile AFTER axi4_lite_if.sv and apb_if.sv,
// with +incdir to dv/agents, dv/env, dv/tests.
// File suffix rule: *.svh = only `included into the package (NEVER compiled alone),
//                   *.sv  = compilation unit (interface, package, slave model, tb_top).
package hrot_dv_pkg;
    import uvm_pkg::*;
    `include "uvm_macros.svh"

    `include "axi4_lite_agent_cfg.svh"
    `include "axi4_lite_item.svh"
    `include "axi4_lite_sequencer.svh"
    `include "axi4_lite_driver.svh"
    `include "axi4_lite_monitor.svh"
    `include "axi4_lite_agent.svh"
    `include "apb_agent_cfg.svh"
    `include "apb_item.svh"
    `include "apb_sequencer.svh"
    `include "apb_driver.svh"
    `include "apb_monitor.svh"
    `include "apb_agent.svh"
    `include "axi4_lite_scoreboard.svh"
    `include "sha256_scoreboard.svh"
    `include "sha256_coverage.svh"
    `include "hrot_env.svh"
    `include "apb_scoreboard.svh"
    `include "apb_coverage.svh"
    `include "apb_env.svh"
    `include "sha256_ref.svh"
    `include "axi4_lite_seq_lib.svh"
    `include "sha256_seq_lib.svh"
    `include "base_test.svh"
    `include "sha256_tests.svh"
    `include "apb_seq_lib.svh"
    `include "apb_tests.svh"
endpackage
