NguyenDinhNhatNguyen/HRoT_SoC/rtl/core/EX_MEM_Reg.v

`timescale 1ns / 1ps

module EX_MEM_Reg(
    input        clk, rst,
    input        stall, // Freeze EX/MEM on bus/memory stall
    // Control signals from EX
    input        RegWrite_EX,
    input        MemWrite_EX,
    input        MemRead_EX,
    input [1:0]  ResultSrc_EX,
    // Data signals from EX
    input [31:0] ALUResult_EX,
    input [31:0] WriteData_EX, // Store data for SB/SH/SW, already forwarded
    input [31:0] PC_Plus_4_EX, // Link value written to rd by JAL/JALR
    input [31:0] PCTarget_EX, // PC + imm, written to rd by AUIPC
    input [4:0]  Rd_EX, // Destination register
    input [2:0]  funct3_EX, // Memory access size (LB/LH/LW/LBU/LHU, SB/SH/SW)

    // Control signals
    output reg         RegWrite_MEM,
    output reg         MemWrite_MEM,
    output reg         MemRead_MEM,
    output reg  [1:0]  ResultSrc_MEM,
    // Data signals
    output reg  [31:0] ALUResult_MEM,
    output reg  [31:0] WriteData_MEM,
    output reg  [31:0] PC_Plus_4_MEM,
    output reg  [31:0] PCTarget_MEM,
    output reg  [4:0]  Rd_MEM,
    output reg  [2:0]  funct3_MEM
);

always @(posedge clk or posedge rst) begin
    if (rst) begin
        RegWrite_MEM  <= 1'b0;
        MemWrite_MEM  <= 1'b0;
        MemRead_MEM   <= 1'b0;
        ResultSrc_MEM <= 2'b00;

        ALUResult_MEM <= 32'b0;
        WriteData_MEM <= 32'b0;
        PC_Plus_4_MEM <= 32'b0;
        PCTarget_MEM  <= 32'b0;
        Rd_MEM        <= 5'b0;
        funct3_MEM    <= 3'b0;
    end
    else if (stall) begin
        // Hold the current EX/MEM values
    end
    else begin
        // Control
        RegWrite_MEM  <= RegWrite_EX;
        MemWrite_MEM  <= MemWrite_EX;
        MemRead_MEM   <= MemRead_EX;
        ResultSrc_MEM <= ResultSrc_EX;

        // Data
        ALUResult_MEM <= ALUResult_EX;
        WriteData_MEM <= WriteData_EX;
        PC_Plus_4_MEM <= PC_Plus_4_EX;
        Rd_MEM        <= Rd_EX;
        funct3_MEM    <= funct3_EX;
        PCTarget_MEM  <= PCTarget_EX;
    end
end

endmodule
