NguyenDinhNhatNguyen/HRoT_SoC/fpga/xilinx/kv260/pintest/pinwalk.xdc

# Pin walk test: the same 8 Pmod pins as ../kv260.xdc (HDA11 to HDA18, 3.3 V bank).
# Source: AMD Kria-PYNQ kv260/base/vivado/constraints/base.xdc, pmod[0] to pmod[7]
set_property PACKAGE_PIN H12 [get_ports {pmod[0]}]
set_property PACKAGE_PIN E10 [get_ports {pmod[1]}]
set_property PACKAGE_PIN D10 [get_ports {pmod[2]}]
set_property PACKAGE_PIN C11 [get_ports {pmod[3]}]
set_property PACKAGE_PIN B10 [get_ports {pmod[4]}]
set_property PACKAGE_PIN E12 [get_ports {pmod[5]}]
set_property PACKAGE_PIN D11 [get_ports {pmod[6]}]
set_property PACKAGE_PIN B11 [get_ports {pmod[7]}]
set_property IOSTANDARD LVCMOS33 [get_ports {pmod[*]}]
set_property SLEW SLOW [get_ports {pmod[*]}]
set_property DRIVE 4 [get_ports {pmod[*]}]
set_false_path -to [get_ports {pmod[*]}]
