NguyenDinhNhatNguyen/HRoT_SoC/fw/hal/test/sb_host_test.c

/* Secure Boot (P-13, P-15) unit test on the host: secure_boot_run() against models of the App ROM,
 * the Boot ROM golden slot, SYSCSR, UART0, GPIO0, the Secure DMA (sb_mock.c) and SHA-256 (sha256_mock.c).
 * Covers the paths that are hard to reach on the RTL: bus error while hashing, broken SHA core,
 * Boot Guard that never finishes, DMA firewall error, DMA that never finishes or is already busy,
 * the relay of the App's Mailbox words to UART0 after a release (P-16), since 04/11 the WDT and
 * Boot Guard LOCK on every failure path, and the Boot_Verifier CHECK with the release gate (I-08).
 * Prints "SB RESULT: PASS|FAIL". */
#include "secure_boot.h"
#include "sb_mock.h"
#include "dma.h"
#include "sha256_mock.h"
#include "sha256_ref.h"
#include "soc_map.h"
#include <stdio.h>
#include <string.h>

static int g_fail = 0;
static int g_pass = 0;

#define CHECK(cond, ...)                                    \
    do {                                                    \
        if (cond) {                                         \
            g_pass++;                                       \
        } else {                                            \
            g_fail++;                                       \
            printf("  FAIL %s:%d: ", __FILE__, __LINE__);   \
            printf(__VA_ARGS__);                            \
            printf("\n");                                   \
        }                                                   \
    } while (0)

/* A 4 KB App image with some code-like words, the rest zero (like a real App ROM) */
static void make_image(void)
{
    static const uint32_t words[] = { 0x02a00093u, 0x00102023u, 0x0000006fu, 0x12345678u };
    uint32_t i;

    memset(g_sb.app_rom, 0, sizeof g_sb.app_rom);
    for (i = 0; i < 4; i++)
        memcpy(&g_sb.app_rom[4 * i], &words[i], 4);
    g_sb.app_rom[SB_APP_VER_OFF] = 1u;                              /* APP_VER = 1 in the last word (I-04) */
    sha256_ref(g_sb.app_rom, sizeof g_sb.app_rom, g_sb.golden);     /* golden = sha256sum of the .bin */
}

static void reset_all(void)
{
    sha256_mock_reset();
    g_mock.busy_polls = 3;
    sb_mock_reset();
    g_sb.dma_busy_polls = 5;
    make_image();
}
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
