NguyenDinhNhatNguyen/HRoT_SoC/(commit log)

2026-09-10 Thêm gitkeep giữ cấu trúc thư mục trên GitHub
2026-09-15 Update 5-stage and tb
2026-10-24 Uncore/SoC: SHA-256, AXI interconnect + WSTRB, cách ly secure boot, testbench SoC
    - SHA-256: lõi đầy đủ 1 vòng/chu kỳ (66 chu kỳ/block, START -> DONE), chaining nhiều
    block (INIT), DONE sticky; bản đồ thanh ghi khớp fw/hal/sha256_regs.h. Qua vector NIST.
    - AXI4_Lite_Slave_Template thành adapter dùng chung (cổng thanh ghi, WSTRB, BRESP/RRESP).
    SoC_Top: interconnect 1 master - 5 slave, default slave trả DECERR, ghi ROM App -> SLVERR.
    - bus_stall tổ hợp = (we|re) & ~resp_valid; AXI master không phát lại request; có WSTRB.
    - Cách ly: Master boot từ Boot ROM riêng (firmware_imem.hex); ROM App chỉ đọc qua AXI.
    Bản đồ Master: Boot ROM 0x0, RA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
2026-10-24 Tuần 8: bus ngoại vi APB + SYSCSR, UART0, GPIO0 (thế giới Secure)
    - AXI4_Lite_to_APB: cầu AXI4-Lite -> APB4 (SETUP/ACCESS, PREADY, PSLVERR -> SLVERR).
    - APB_Decoder: 8 cửa sổ 4 KB tại 0x4000_0000, cửa sổ trống -> PSLVERR.
    - SYSCSR (0x4000_0000): APP_CTRL ở offset 0 (tương thích Reset Controller cũ), CHIP_ID,
    VERSION, BOOT_STRAP, RST_CAUSE (giữ qua SW/WDT reset), SW_RESET có khóa; sinh sys_rst.
    - UART (0x4000_1000): 8N1, lấy mẫu 16x, FIFO TX/RX 8 byte, overrun/frame error, ngắt.
    - GPIO (0x4000_2000): 8 ra/8 vào, đồng bộ 2 tầng, ngắt cạnh lên W1C.
    - Sync_FIFO dùng chung. Bỏ Reset_Controller (SYSCSR thay).
    - SoC_Top: thêm chân uart0_tx/r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
2026-10-24 Tuần 8: bộ nhớ đồng bộ (M4K/BRAM), luồng FPGA DE2 + Xilinx, VP secure boot, Makefile
    - Bộ nhớ đọc/ghi đồng bộ ở cạnh xuống (Instruction_Memory, Dual_Port_ROM, Data_Memory):
    suy ra M4K/BRAM, lõi vẫn thấy dữ liệu trong cùng chu kỳ -> không cần sửa lõi.
    Trước đó Quartus báo lỗi 276003 (ROM/RAM đọc tổ hợp không vào được M4K).
    - syn/intel_de2: DE2_Top (bọc chân), constraints.sdc, de2_pins.tcl, build.tcl (Quartus 13.0sp1).
    Kết quả: 7.453 LE (22%), 135 Kbit M4K (28%), Fmax 54,9 MHz @ 50 MHz.
    - syn/xilinx: Xilinx_Top, constraints.xdc (chuyển từ syn/), build.tcl (Vivado non-project).
    Thử Artix-7 xc7a35t: 3.125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
2026-10-24 Giữ LF cho *.sh, Makefile, *.tcl (chạy được trong WSL)
2026-10-24 UVM SHA-256 random + corner case on DUT
2026-10-24 Add TIMER0 and WDT on the APB bus (N-15, N-16, N-17)
    TIMER0 is CLINT-style: 64-bit mtime/mtimecmp with a level irq (not wired into the core
    until P-09 adds irq_timer). WDT counts down from LOAD, locks LOAD and EN once enabled,
    reloads on a keyed KICK and resets the Secure world through SYSCSR (RST_CAUSE.WDT).
    APB_Periph_tb gains 14 checks (42/42), memory map updated.
2026-10-24 Switch comments and test output to English
    Comments in Nguyen's RTL, testbenches, VP, scripts and FPGA files are now English, and so is
    everything the tests print. Testbenches end with "<tb> RESULT: PASS|FAIL", which
    regress.sh now looks for. Test names in APB_Periph_tb may be up to 48 characters.
2026-10-24 Update docs and add folder READMEs
    README files for the repo, docs/, rtl/, dv/, fpga/ and vp/. Memory map covers TIMER0, WDT
    and the SHA-256 window. Tables use the "| --- |" separator style.
2026-10-24 One statement per line in RTL, VP and testbenches
    The statement after if/else/for/while and after each case label now sits on its own line,
    and no line holds more than one ';'-terminated statement. Layout only: make test results
    and mkhex.py output are unchanged. Dev_Guide records the rule. Also tidies a few VP log
    messages.
2026-10-25 Add PLIC-lite and Mailbox (N-19)
    PLIC-lite merges 8 level-sensitive sources into one external-interrupt line with a fixed
    priority (the lowest index wins) and a CLAIM register. Mailbox is the data bridge between
    the Secure and App worlds: one word each way with FULL flags and an interrupt per side,
    reachable from two APB ports. APB_Periph_tb gains 20 checks (69/69), and apb_rd now waits
    1 ns after the access like apb_wr, so a check right after a read sees the popped state.
2026-10-25 Add Boot Guard and zeroization to SYSCSR (N-20)
    GUARD (0x20): writing 1 to LOCK holds the App Core in reset until the next power-on reset,
    whatever APP_CTRL says and whatever a software or watchdog reset does. LOCK also starts a
    state machine that walks every word of the App RAM and exposes it as app_zero_en and
    app_zero_addr, so the SoC can clear the RAM of a rejected image. APB_Periph_tb checks the
    lock, the one-pass sweep, that a software reset keeps the lock and that only a POR clears it (79/79).
2026-10-25 Build the Week 8-10 Secure world and the App world into SoC_Top (N-21, N-22 to N-25, N-35)
    Secure side:
    - Boot ROM becomes a Dual_Port_ROM. Port B is a read-only AXI slave at 0x0000_0000, so firmware
    can keep constants such as the golden hash in ROM (N-21). Instruction_Memory is no longer used.
    - One shared AXI master now serves the CPU and the new Secure DMA, round robin, with the DMA
    behind DMA_Firewall (N-22, N-23). The DMA streams the App ROM into SHA-256 block by block, can
    add the padding block and swap bytes, and the firewall lets it touch nothing else.
    - PLIC-lite (APB slot 5), Mailbox Secure side (slot 6) and Secure DMA (slot 7) fill the APB bus.
    - Boot Guard zeroization borro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
2026-10-25 Update the VP to match the RTL (N-27, N-32)
    The VP now has the Boot ROM (the golden hash is read over the bus like in the RTL firmware),
    UART0 (prints what the firmware sends and keeps a log), TIMER0 (50 MHz mtime from simulation time),
    the WDT (counts, never resets), Boot Guard LOCK in SYSCSR and a functional Secure DMA with the same
    registers and firewall rule as the RTL. The CPU model logs its progress over UART0, times the hash
    with TIMER0, kicks the WDT, checks the DMA digest and the firewall, and on a mismatch locks the
    App out and tries to release it anyway. The VP digest equals the RTL's SWAP=1 digest, which is
    sha256sum of the .bin. VP RESULT now also checks the UART log, the WDT ki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
2026-10-25 Prepare the data_err and interrupt wiring for P-09 (I-01)
    SoC_Top now builds master_data_err (high in the response cycle of a CPU access that got SLVERR
    or DECERR) next to the interrupt wires, and every TODO(P-09) comment names the core port to
    connect. PLIC notes that writing CLAIM/COMPLETE is accepted and does nothing, since the sources
    are levels that drop when their own device is serviced.
2026-10-25 Update docs, soc_map.h and FPGA reports for the Week 8-10 hardware
    SoC_Memory_Map covers the Boot ROM data window, GUARD, PLIC-lite, Mailbox, Secure DMA with its
    firewall and the App-world map. soc_map.h gets the same registers and bit masks. Project_Status
    and Project_Plan record N-19 to N-25, N-27, N-32 and N-35 as done and add risks R15 to R18, among
    them the Quartus 13 error that commit fb0b577 introduced in IF_ID_Reg and ID_EX_Reg. FPGA reports
    are from the 26/10 run: DE2 9,358 LE at 53.02 MHz, Artix-7 5,530 LUT with WNS +3.519 ns, measured
    with the synchronous-reset fix for those two core files.
2026-10-26 Add Zicsr, machine traps and interrupt ports (P-09), move UVM tops (P-10), add UART/GPIO drivers (P-11), sync reset in IF_ID/ID_EX (P-23)
2026-10-27 Add the Secure Boot firmware (P-13) and SoC interrupt tests with the IRQ lines wired (P-14)
2026-10-28 Hash the App ROM with the Secure DMA in Secure Boot (P-15)
    Add the Secure DMA driver fw/hal/dma.c (dma_sha256: bounded polling with a pause, firewall/bus/timeout errors, SHA-256 left alone on timeout, R17). Secure Boot now hashes the 4 KB App ROM with SWAP and PAD, matching the golden hash at 0xFE0 (I-04), and the CPU no longer reads the App ROM. Extend sb_host_test with DMA cases (63/0), check the DMA run in SoC_Fw_tb, build dma.c in CMake, the host tests and the VP, and update the docs.
2026-11-04 Add Boot_Verifier and the hardware release gate (N-37)
    Boot_Verifier sits on APB slot 8 (0x4000_8000). It fetches the expected digest
    from the Boot ROM through a new read port and compares all 8 words with the
    SHA-256 result, so firmware can no longer fake the verdict. With VERIFY_GATE
    set, SYSCSR ignores APP_RUN until the block reports VERIFIED. It also holds the
    anti-rollback floor (MIN_VER), the HMAC key slot and a sticky KEY_LOCK.
    VERIFY_GATE stays 0 on the board top and in the firmware testbenches until the
    firmware uses CHECK (I-06). Boot_Verifier_tb adds 30 checks and the SoC test
    now runs with the gate on. The APB window test moves to 0x4000_9000.
2026-11-04 Trap CPU bus errors in the Master core and turn the release gate on for the FPGA tops (P-24, N-37)
    SoC_Top now drives the Master core's data_err with SLVERR and DECERR responses to
    CPU accesses (DMA errors still go to the DMA and SYSCSR.BUS_ERR). The mkhex.py test
    program makes seven bus errors on purpose, so it gets a trap handler that resumes
    after the faulting instruction and counts the faults, and the program fails if the
    count is not seven.
    DE2_Top and Xilinx_Top set VERIFY_GATE to 1. The test program runs CHECK before it
    releases the App Core, like the Secure Boot firmware does.
2026-11-04 Update the READMEs and docs for Boot_Verifier and add the SoC block diagram (N-37, N-38)
    The root README, Dev_Guide, Project_Plan, Project_Status and the rtl and dv READMEs
    now list Boot_Verifier at 0x4000_8000, the 4 KB memory decode, the wired data_err
    and the latest FPGA numbers. SoC_Block_Diagram.drawio shows both worlds, the buses,
    the peripherals and the release gate.
2026-11-04 Connect the IRQ External wire to the Master Core in the block diagram
2026-11-04 Add the internal blocks of the core, DMA, SHA-256, AXI master and SYSCSR to the diagram
2026-11-04 Add the architecture diagrams and operation flowcharts as one multi-page draw.io file with PNG exports (N-31)
2026-11-07 Fix the fail() step order in the flowcharts, add make cov to the verification flow and drop unused diagram code (N-31)
2026-11-07 KV260: PL clock from the IOPLL at 50 MHz, PMOD pins from AMD's XDC, bitstream and board firmware files (N-29)
2026-11-07 Group the FPGA flows by vendor and kit: intel/de2, xilinx/artix7, xilinx/kv260 (N-29)
2026-11-07 KV260: add Pmod and J2 pin numbers to the pin table, record the overlay IDs checked against linux-xlnx (N-29)
2026-11-07 KV260: cross-check the Pmod J2 pin numbers against AMD's Kria-PYNQ XDC and a third-party XDC (N-29)
2026-11-07 Add HANDOFF.md with the pending board checks and unverified items (N-29)
2026-11-07 KV260: confirm the Pmod J2 pin numbers against AMD's carrier card schematic XTP682 (N-29)
2026-11-07 KV260: add a Pmod pin walk test to check the J2 wiring on the board (N-29)
2026-11-07 Update HANDOFF.md with the schematic check and the final build results
2026-11-07 Add the KV260 Pmod J2 pin diagram (drawio and png) (N-29)
2026-11-07 Add power estimates to the FPGA flows and the PPA report for DE2, Artix-7 and KV260 (N-30)
2026-11-07 Add an ASIC SDC skeleton for SoC_Top, the clock period is left to the PD flow (N-30)
2026-11-07 Add a Yosys + NanGate45 trend flow for SoC_Top with black box memories (N-30)
2026-11-07 Record the Yosys trend numbers and the school server flow in HANDOFF.md
2026-11-12 Add a Genus flow for ASIC_Top and block PDK files repo-wide
